gbfans/afterlife-lightkit/(threads)

Thread 1 (2022-06-20):

What is the preferred software for development?

cfunseth, 2022-06-20:
There will likely be library dependencies for the software, and the hardware may require modifications from multiple people. This makes documentation difficult if everyone is using a different environment to develop in.

I'd throw a vote out for just using Arduino and KiCAD since these are both popular and available for anyone to use.

Just throwing it out there for consideration before design progresses too far.

ajquick, 2022-06-20:
I would agree that those are my preferences as well. Once you start using VS Code or other software it becomes more complicated for end users to compile their own code.

The PCB was designed in Kicad, so that's what the source will be provided as. I may put up a PDF schematic here soon as I like to test a physical board before I release anything else publicly.

Thread 3 (2022-06-21):

[FEATURE] Recreation of 1984 Cyclotron Effect

prodestrian, 2022-06-21:
The most basic requirement for this project to get to a first release is the 1984 Cyclotron Effect, effectively a "Hello World" task but a great way for us to refine our processes before jumping into the heavier stuff.

Based on the [schematic](https://github.com/gbfans/afterlife-lightkit/blob/main/HARDWARE/Schematic.pdf), I assume we'll be running `WS2812` LED strips (Neopixels)?

## Acceptance Criteria
- I should be able to compile and upload the Arduino code to the Microcontroller
- The four LEDs should illuminate in a looped sequence (approx 500ms each) as soon as the sketch starts, one at a time

## Out of Scope
These can be added in subsequent updates once the proof of concept is tested and more of the code boilerplate has been implemented:
- Multiple LEDS per Cyclotron light (eg 4x5LEDs, or a 20-LED strip)
- Customization (interval, brightness, direction, number of LEDs)
- Fadeout effects (incandescent-lamp style)

## Proof of concept sketch
(NOTE: Untested as I don't currently have the hardware available, but in theory this should upload and work with minimal changes)
```ino
#include <Adafruit_NeoPixel.h>

// D1 / GPIO5 = Cyclotron Light Data Out
#define CYCLOTRON_PIN 5

// How long to illuminate each Cyclotron LED
#define CYCLOTRON_DELAY 500

// How many LEDS in the Cyclotron
#define CYCLOTRON_LED_LENGTH 4

// Parameter 1 = number of pixels in strip
// Parameter 2 = Arduino pin number (most are valid)
// Parameter 3 = pixel type flags, add together as needed:
//   NEO_KHZ800  800 KHz bitstream (most NeoPixel products w/WS2812 LEDs)
//   NEO_KHZ400  400 KHz (classic 'v1' (not v2) FLORA pixels, WS2811 drivers)
//   NEO_GRB     Pixels are wired for GRB bitstream (most NeoPixel products)
//   NEO_RGB     Pixels are wired for RGB bitstream (v1 FLORA pixels, not v2)
Adafruit_NeoPixel cyclotron = Adafruit_NeoPixel(CYCLOTRON_LED_LENGTH, CYCLOTRON_PIN, NEO_GRB + NEO_KHZ800);

uint16_t currentCyclotron = 0;
unsigned long previousCyclotronMillis=0;

uint32_t red = cyclotron.Color(255,0,0);

void setup() {
  cyclotron.setBrightness(255); // set brightness

  cyclotron.begin();
  cyclotron.show(); // Initialize all pixels to 'off'
}

void loop() {
  tickCyclotron();
}

void tickCyclotron() {
  if (
    ((unsigned long)(millis() - previousCyclotronMillis) >= CYCLOTRON_DELAY)
    || previousCyclotronMillis == 0
    ) {
    previousCyclotronMillis = millis();
    cyclotron.clear();
    cyclotron.setPixelColor(currentCyclotron, red);

    currentCyclotron++;

    if (currentCyclotron == CYCLOTRON_LED_LENGTH) {
      currentCyclotron = 0;
    }

    cyclotron.show();
  }
}
```

ajquick, 2022-06-21:
Yes this works.

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

I also made the following change:

````
// How long to illuminate each Cyclotron LED
#define CYCLOTRON_DELAY 20

// How many LEDS in the Cyclotron
#define CYCLOTRON_LED_LENGTH 40
````

And now it functions as the Afterlife Cyclotron.

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

@cfunseth also has written code that already works for Afterlife and has the ramping speed up effect: https://github.com/cfunseth/AfterlifeCyclotron

If I recall it also has 1984 mode that places the pixels in the correct spot depending on the number of LEDs.

Currently my test ring has 40 leds, but I believe the final version that will ship with the kit has 32 or 35 LEDs.

ajquick, 2022-06-21:
BTW. I really like the idea of having separate branches for things to test maybe? I typically just commit to master, but I think separate branches for each effect being tested or whatever would be good?

The basic bare setup will be easy, it is once we start adding all the different modes and customizations that things will get hard. So if we can find a way to keep those very portable that would be good.

I'm using just an Arduino and LED ring to test as I don't have an ESP8266 on hand at the moment, but it should be easy to swap between the two devices for the time being.

ajquick, 2022-06-21:
I attempted to get the powercell sequence working, however my knowledge of the Neopixel library fell flat. I was unable to turn the LEDs off in reverse sequence.. even though it *should* have done it.

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

```c
#include <Adafruit_NeoPixel.h>

// D1 / GPIO5 = Powercell Light Data Out
#define POWERCELL_PIN 3

// How long to illuminate each Powercell LED
#define POWERCELL_DELAY 20

// How many LEDS in the Powercell
#define POWERCELL_LED_LENGTH 40

// Parameter 1 = number of pixels in strip
// Parameter 2 = Arduino pin number (most are valid)
// Parameter 3 = pixel type flags, add together as needed:
//   NEO_KHZ800  800 KHz bitstream (most NeoPixel products w/WS2812 LEDs)
//   NEO_KHZ400  400 KHz (classic 'v1' (not v2) FLORA pixels, WS2811 drivers)
//   NEO_GRB     Pixels are wiblue for GRB bitstream (most NeoPixel products)
//   NEO_RGB     Pixels are wiblue for RGB bitstream (v1 FLORA pixels, not v2)
Adafruit_NeoPixel powercell = Adafruit_NeoPixel(POWERCELL_LED_LENGTH, POWERCELL_PIN, NEO_GRB + NEO_KHZ800);

uint16_t currentPowercell = 0;
unsigned long previousPowercellMillis=0;

uint32_t blue = powercell.Color(0,0,255);
uint32_t off = powercell.Color(0,0,0);

uint16_t powercell_direction = 1;

void setup() {
  powercell.setBrightness(50); // set brightness

  powercell.begin();
  powercell.show(); // Initialize all pixels to 'off'
}

void loop() {
  tickPowercell();
}

void tickPowercell() {
  if (
    ((unsigned long)(millis() - previousPowercellMillis) >= POWERCELL_DELAY)
    || previousPowercellMillis == 0
    ) {
    previousPowercellMillis = millis();
    //powercell.clear();

    if (powercell_direction > 0) {
      powercell.setPixelColor(currentPowercell, blue);
    } else {
      powercell.setPixelColor(currentPowercell, off);
    }

    currentPowercell = currentPowercell + 1 * powercell_direction;

    if (currentPowercell == POWERCELL_LED_LENGTH) {
      powercell_direction = -1;
    }else if (currentPowercell == 0) {
      powercell.clear();
      powercell_direction = 1;
    }

    powercell.show();
  }
}
```

ajquick, 2022-06-21:
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

```c
void tickPowercell() {
  if (
    ((unsigned long)(millis() - previousPowercellMillis) >= POWERCELL_DELAY)
    || previousPowercellMillis == 0
    ) {
    previousPowercellMillis = millis();
    //powercell.clear();

    for (int i = 0 ; i < POWERCELL_LED_LENGTH; i++) {
      if (i <= currentPowercell) {
        powercell.setPixelColor(i, blue);
      } else {
        powercell.setPixelColor(i, off);
      }
    }

    currentPowercell = currentPowercell + 1 * powercell_direction;

    if (currentPowercell == POWERCELL_LED_LENGTH) {
      powercell_direction = -1;
    }else if (currentPowercell == 0) {
      //powercell.clear();
      powercell_direction = 1;
    }

    powercell.show();
  }
}
```

prodestrian, 2022-06-21:
Excellent! So, to be completely clear the above code I posted was just to verify that it would work on the hardware, which is why it's so hastily written.
So the next step is to refactor this into something cleaner and more permanent as a starting point to build upon, and that can be our first actual release of the code before we move onto the next feature.
I'm happy to include the POWERCELL feature as part of that, I've already got most of that code written cleanly.

I think the next feature is wrapping our heads around the Configuration, I was going to create a new Issue to track this because it may need some discussion and investigation. I see you've already got something to look at in #4 so I'll have a play when I pick up an ESP8266 later this week.

For that feature, we'd want to be able to manipulate the speed (CYCLOTRON_DELAY) using the web browser.
If we get that minimum requirement working, everything after this point should be smooth sailing because it's all just variations of the same thing.

prodestrian, 2022-06-21:
And yes, separate branches are a good idea, we almost never want anything being committed to `main` directly. I usually lock that branch to force every change to go through a PR (and a code review). Should hopefully reduce the chance of bad code or regressions being introduced.

prodestrian, 2022-06-24:
I finally have an ESP8266 as well now, so tomorrow I'll solder the headers on and get it working with my Neopixels.

I've played with WLED quite a bit, it's why I purchased an ESP32 originally. I don't think we really need it here, but some of the animation code could be handy.

I'm not worried about running multiple animations at once, I've already got two separate Neopixel strips animating on my pack while _also_ mixing 3 channels of Audio playback and reading/writing packets over Serial. I can be firing and overheating while changing my volume (from the wand) and playing music at the same time. Zero lag if the code is written efficiently.

Here's a video demo of where my animations are at (I'm building a new pack so these will be rewritten in the near future):
https://www.youtube.com/watch?v=F4Oospy0Dfc
There's a fade-up/down on the PowerCell and Cyclotron during startup.
The Cyclotron LEDs also have a fake "incandescent" fadeout when they switch off.

I'm doing all of this with TimedAction: https://playground.arduino.cc/Code/TimedAction/

What I'd like to do is abstract this all out to smaller components so our main sketch only has to be concerned with the "business logic".

Here's a mockup of what we could end up with:
```ino
// 60-LED Neopixel ring, for example
#define CYCLOTRON_LENGTH 60
// Max brightness
#define CYCLOTRON_BRIGHTNESS 255

Cyclotron cyclotron = Cyclotron(CYCLOTRON_LENGTH, CYCLOTRON_BRIGHTNESS);

void setUp() {
    // Initial Speed
    cyclotron.setSpeed(500);
    // Afterlife Mode
    cyclotron.setMode(MODE_AFTERLIFE);
    // Cyclotron is off by default
    cyclotron.disable();
}

void loop() {
    if (packIsActive()) { // Some magic function which reads the state of the power switch
        cyclotron.enable();
        if (packIsFiring()) { // Fire button is pressed
            // Tells the Cyclotron to spin faster
            cyclotron.setSpeed(250);
        } else {
            // Return cyclotron to regular speed
            cyclotron.setSpeed(500);
        }
    } else {
        // Switch off the Cyclotron LEDs
        cyclotron.disable();
    }

    // This is the line which makes it actually work
    cyclotron.update();
}
```

Obviously the above code is completely artificial, but note how we're not really having to deal with the LED animations or timers here, and there's no blocking code either. The Cyclotron class would initiate the TimedAction instance and the Neopixel strip, we don't have to think about it in the main sketch.

We can tell the Cyclotron and PowerCell instances how long we've been firing for, and have them calculate/adjust their own speed accordingly (or maybe keep it simple and just say `cyclotron.setIsOverheating(true)`). There's a lot of possibilities, we just need to imagine them! :smiley:

Thread 4 (2022-06-21):

Portability between Microprocessors?

ajquick, 2022-06-21:
For this version of the hardware I have decided to use the ESP8266 as the microprocessor. The main reason for that was the following:

* It's cheaper than most Arduino clones (nano, mini, micro),
* It has a 32-bit processor, which may be better at driving a large number of LEDs quickly(?)
* It has a ton of hardware features like Wi-Fi and is more next-gen than most simple Atmega chips.

That being said. There will only be a few things that the ESP8266 can do that the Arduino chips cannot and that is primarily running the web server and Wi-Fi connection. I think it would be ideal to allow for portability between boards so that an Arduino could be used if need be.

It would be good to have the settings stored and accessible with the ability to change them over the command line.

I've actually already written two utilities for a program that are run on the ESP32 to change settings:

https://github.com/CNCxyz/Grbl_Esp32_Utility (Qt program, EXE)
https://github.com/CNCxyz/Grbl_Esp32_Web_Utility (Web utility)

The web utility is what I would focus on and could adapt. It allows someone to plug their device into a computer and visit a web page in Chrome. Chrome can communicate with the device over the serial port and the configuration can be read and written back without downloading anything.

That would help people that may not want to go through the hassle of downloading Arduino and compiling customizations.

I think having the ability to disable Wi-Fi completely using the serial port would be ideal as well. It would help speed up the boot time.

prodestrian, 2022-06-21:
Just leaving this note for later, it should be possible to add conditional includes in our Arduino code which only require/enable certain features based on the board type. So if you're compiling for an ESP8266 it will include the Wifi features, otherwise (eg Arduno Nano) it will just use all the configuration default values.

We'll want a default config file (eg `config.h.default`) which users clone to `config.h` and modify all the settings (Cyclotron speed, mode, directions, etc) as needed. We'll want `config.h` gitignored too. This way users can still `git pull` to get the latest features.

We may need to implement a Configuration provider which is intelligent enough to load settings from the three different scopes:
1. From the Wifi-defined configuration (if enabled)
2. From the user-overridden `config.h`
3. From the hard-coded default value

One thing I'm not sure about is where we'll actually store this configuration (it may need a separate Issue to track this).
I know the ESP8266 has an onboard EEPROM, but it has a limit of `100,000` write cycles. Is that enough?
If we're only writing to EEPROM when Configuration is changed, it should be fine (you could change your CYCLOTRON speed 25 times a day and still get 11 years out of your device). But if we're not smart about it and we're constantly writing to it, we're going to burn out the board.
The alternative is to write to the SD Card. I personally prefer the sound of this, but I don't know if this will introduce undesirable latency, or how difficult it will be to read/write config files to the filesystem. I'd hope that there's some libraries around to handle this already, but I don't know how lightweight they are.

ajquick, 2022-06-21:
I would prefer the EEPROM approach personally. I don't think we'll have a problem with that many cycles. These D1 Mini boards are about $3-4 on Amazon, so not bad.

For the web server portion, I think we will need to implement a LittleFS (file system) to store a HTML page, CSS and could potentially also store the config there as a JSON file. Space will be tight, but I'm sure we wouldn't be using more than a 1/4 of the memory space for that.

Definitely plan on having a ```#define BOARD = ESP8266;``` or something at the top to allow for the includes to be changed.

prodestrian, 2022-06-24:
I've done some testing and added some notes in #5 related to the filesystem and webserver.

[Apparently](https://arduino.stackexchange.com/questions/34496/how-to-have-compiler-know-whether-arduino-or-esp8266) we can use this to detect the device automatically, so users won't need to change anything themselves when compiling:
```ino
#if defined(__AVR__)
// AVR specific code here
#elif defined(ESP8266)
// ESP8266 specific code here
#endif
```

Thread 5 (2022-06-22):

Webserver Demo

ajquick, 2022-06-22:
I have created a branch with a webserver demo:

https://github.com/gbfans/afterlife-lightkit/blob/webserver/SOFTWARE/Webserver.ino

Currently the code will do the following:

- Start the access point with the name "Afterlife " + MAC ADDRESS
- Start a webserver on board the ESP8266
- Start a DNS server (255.255.255.0)
- Set a static IP address (10.10.10.1)
- Start the LittleFS file system (doing nothing currently)
- Initialize the Eeprom (no data stored currently)

Now it is supposed to start the DNS server and handle all requests to the internet and then display a Hello World page for everything. However it does not currently do that.

Accessing through http://www.msftconnecttest.com/redirect or the device's static IP of http://10.10.10.1/ does show the "Hello World" page.

ajquick, 2022-06-24:
Can you push your code to the webserver branch? Getting interactions is the next step, and its something I can focus on doing if you would prefer. I just need API end points to save config data and trigger events.

>But if I try accessing a site I've visited previously, I get a CONNECTION_REFUSED error because 99% of those sites are on HTTPS (usually with HSTS-enabled, which my browser remembers and won't allow me to connect via HTTP). So my browser tries to connect to port 443, but the webserver is only listening on port 80, and so I get the error.

This makes sense. Also because on sites previously visited the DNS is cached on your device, so it's probably trying to connect to whatever IP that isn't the ESP8266.

>Edit: I need to have a play with this: https://github.com/plapointe6/EspHtmlTemplateProcessor
>Maybe starting with this tutorial: https://randomnerdtutorials.com/esp8266-web-server-spiffs-nodemcu/

These both use SPIFFS as the file system. I had planned on going with LittleFS since I think it is a little easier to deal with loading files on to the ESP8266. If you have any insight into that, let me know. Basically I think LittleFS can just have a "data" directory with raw files (index, js, css, jpg.. etc) that can be accessed or fed directly instead of having things in the Arduino code.

prodestrian, 2022-06-25:
Yep, I'll push my code shortly :+1:

> These both use SPIFFS as the file system. I had planned on going with LittleFS since I think it is a little easier to deal with loading files on to the ESP8266. If you have any insight into that, let me know.

After a bit of research, it looks like SPIFFS is deprecated/unsupported anyway, plus LittleFS is apparently more performant. So let's stick with LittleFS:
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
https://arduino-esp8266.readthedocs.io/en/latest/filesystem.html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,times%20faster%20for%20most%20operations.

I can't find any HTML template libraries which support LittleFS, but I don't think that's a dealbreaker anyway (we're not going to building anything too complex here).

I was able to convert the Webserver demo to store the HTML file in LittleFS, the only catch is that I couldn't get it working with `ESP8266WebServer` so I had to swap out for `ESPAsyncWebServer` (which also requires installing `ESPAsyncTCP`).

I'll commit what I have so you can try it out: #9

prodestrian, 2022-06-25:
Now that I've got my hardware connected (See #7) I tried to perform an integration test with the Webserver code and my Neopixel code.
Everything connects and I can even click the HTML buttons to change my animation speed.
But then **the Wifi network drops out**, within about 10 seconds. The LED animations continue fine.

I'm currently powering the Neopixels directly from the ESP8266, I thought maybe the current draw was too much for the Wifi. But even after disconnecting the Neopixels entirely the Wifi still drops out.

So I commented out my animations and left just the webserver (and dependencies), the Wifi stays up fine. Next thing I tried was removing the animations and just setting the colour of one of the Neopixel strips based on the button presses (no timers etc, just the Adafruit Neopixel library). This still dropped out unfortunately. So pretty much ruled out my animations and the Timers, I think it's Neopixels interfering with Wifi.

I jumped onto the Adafruit GitHub and searched for ESP8266 and found this Issue:
https://github.com/adafruit/Adafruit_NeoPixel/issues/176

That led me here: https://forum.arduino.cc/t/interrupting-the-neopixels-help-needed/495593

> One of the problems in that the NeoPixel library temporarily disables all interrupts when issuing data, then re-enables them when done. Since a lot of those functions are essentially always updating the LEDs, well then you don't have room much for anything using interrupts.

**We're not be able to use Wifi and the Adafruit Neopixel library at the same time.**

What alternatives are out there?
https://github.com/Makuna/NeoPixelBus/wiki/Library-Comparisons
NeoPixelBus seems to have been designed for exactly this reason. I brought it into my sketch with minimal effort, but it looks like it unfortunately requires you to use specific GPIO pins on the ESP8266 (it ignores the pin you configure). This won't work if we're already committed to specific pins on the PCBs. Also doesn't seem to like running multiple Neopixel strands at once.

So, next up I tried FastLED. It took a significantly bigger rewrite to get up and running. But it mostly works (with a couple of weird hacks that I found others had to use on the ESP8266), and the logic of my original animations translates very pretty easily. In fact I actually like some aspects of it more than the Neopixel library.

I now have a working demo with the Cyclotron LEDs and Webserver/Wifi. I can control the speed of the Cyclotron over Wifi:
https://www.youtube.com/watch?v=rnBNd0qfW8Q

There are still some random glitches/flickering in the Cyclotron LEDs though. If I disable Wifi it runs smoothly, so there's potentially some adjustments/optimizations to be made there. I've barely scratched the surface of the documentation.
Also I'm not (currently) using a 3.3V logic level shifter, I forgot to pick one up yesterday so it'll be another week before I can get one. It's possible that's causing the flickering, very hard to tell though.

If it's not a solvable problem, then that unfortunately rules out "Party Mode" :rofl:

ajquick, 2022-06-25:
Regarding the flicker, are there any wires or large metal surfaces (ground planes) near the Wi-Fi antenna?

Perhaps a good idea to check to see what Wled has done because I suspect they have tackled all these issues. They already use the Async webserver, LittleFS, FastLED.. etc. So it is definitely possible.

prodestrian, 2022-06-26:
It's plugged into a breadboard sitting on a wooden desk, I don't think there's any interference.

I'm installing WLED to see if I have the same problem, but I'm feeling pretty confident it's a hardware issue now.

I also ordered some [bidirectional logic level converters](https://core-electronics.com.au/logic-level-converter-bidirectional.html), I did find a `74LVC245` in my collection but it seems to be 5V to 3.3V, not 3.3V to 5V which is what I need (unsuitable for Neopixels). So it'll be at least a few days before that arrives.

prodestrian, 2022-06-26:
I've been trying to decipher the code from WLED but it's so heavily abstracted that I just can't understand it. I did find a few small configuration options which seemed to relate to ESP8266 but none had any effect. The flicker remained when I brought it into my sketch.
Eventually I found this post: https://github.com/FastLED/FastLED/issues/849
which linked to this commit: https://github.com/stnkl/FastLEDHub/commit/54bbaf1d12c89977501e1dea95f9347ae0a954ed

I copied it into my sketch and :boom: no more flickering. My guess is that WLED isn't affected because they're doing all the LED communication themselves at the lowest (pin) level (which is why there's no `FastLED.show()` anywhere in their code).

It's an ugly hack but it should be enough to keep us going, I'll include some comments so we can periodically check on the original issue and see if someone resolves it.

prodestrian, 2023-06-12:
The demo of the webserver is completed (as documented in #10) so I believe we can close this too.

Closed 2023-06-12.

Thread 6 (2022-06-22):

ESP8266 Interrupt Pins

ajquick, 2022-06-22:
An important detail to discuss, know about. The ESP8266 has several interrupts which can be used on nearly every GPIO pin with the exception of D0/GPIO16, When I was designing the schematic, I only had 5 pins left to assign my inputs for control over the lights. 1 of them was output only and 1 of them had no interrupt (D0/GPIO16).

I determined to assign the input signals in the following way:

D0 - Fire input signal
D5 - Video game change mode signal
D6 - Activate venting signal
D7 - Activate lights / enable signal

D5 - D7 are able to have interrupts attached, D0 (fire signal) is not able to.

I decided that it was least important to capture the fire signal immediately. The reason for this is that I imagine when someone presses the fire button, they will be holding that button down so it can be captured at the start of the loop as long as it is still held down. Similarly the activate / enable and venting signal are expected to be on for a fairly long time when they are activated, but are more important than the fire signal.

Lastly the video game change signal is expected to always be a very short burst or short tap. This is actually the only one where an interrupt is very important as we don't want to miss the signal. The rest don't **need** the interrupt, but enable and vent do have the ability to have them if they need.

prodestrian, 2022-06-24:
Do we actually _need_ interrupts though? I've never had any issues with responsiveness, my fire button responds to even the shortest/lightest touch.

I'm not using the ESP8266 in my projects so I could be missing something, but I have a Teensy 3.2 in my want and I read the button state, if the fire button is pressed it sends a string over Serial to the Teensy 3.2 in the Pack, which triggers the lights/sounds. All of this occurs in a tiny fraction of a second, and I've never pressed the button and had it not fire.

As long as we're not introducing delays into our `loop()` I wouldn't have expected us to have any issues here?
I haven't tested the WebServer with a button yet so I don't know if this introduces lag, but apparently the ESPAsyncWebServer (alternative library) is a more optimised alternative if we need it:
https://github.com/me-no-dev/ESPAsyncWebServer#why-should-you-care

Personally I use the `Bounce2` library to handle buttons/inputs and debouncing, so far everything has been incredibly reliable:
https://github.com/thomasfredericks/Bounce2

Again, there could be other factors I'm not aware of, but I still feel like we can get by without these. Everything I've read suggests that it's not a good idea to use Interrupts for buttons (or human inputs), it's usually for things like sensor data.

I'll try to get some headers soldered to my board tomorrow so I can connect some pushbuttons and verify this, I can try pressing buttons repeatedly while making a lot of simultaneous webServer requests and see if any of the presses are missed or delayed. Maybe then connect up my Neopixels and make sure that it's all 100% asynchronous and non-blocking.

ajquick, 2022-06-24:
>Do we actually need interrupts though?

The only thing I can say is *I don't know*. But I did put thought into it that if we need interrupts, those are the pins to put them on. Change mode may be the only input that may need one, but if everything is kept really fast than it might be okay to not need it.

[ESPAsyncWebServer](https://github.com/me-no-dev/ESPAsyncWebServer#why-should-you-care) seems like a no-brainer if it is comparable in memory usage. For 99.9999999% no one will be using the webserver for anything beyond initial setup. Perhaps the web server should shut down if no one connects to it within the first 2-3 minutes? And a configuration setting to enable / disable the web server would also be good.

Personally how I would set this up on my own pack is to wire everything up. Use the Wi-Fi to configure all my options and then turn off Wi-Fi permanently. If I need it back on, then I could connect over USB to re-enable it.

That is unless having 'party mode' where you can have cool light shows come on based upon a click on your phone is highly desirable for end users.

prodestrian, 2022-06-25:
If we wanted we could have a secret button press to switch Wifi on/off. Maybe while the pack is in shutdown mode, hold the Vent button for 5 seconds to activate Wifi, hold for 5 seconds again to shut it down? Slowly blink the Orange Hat light to show when it's active?

We can also automatically enable Wifi if the Configuration (in either EEPROM or LittleFS) is empty. So you can do your initial configuration, but then it skips enabling Wifi afterwards unless you manually activate it.

Thread 7 (2022-06-24):

[FEATURE] Recreation of 2021 Afterlife Spinning Cyclotron Effect

prodestrian, 2022-06-24:
Just so we have a place to keep all our discussions/ideas for this feature together once the code for #3 is completed.

The requirement here is that we should be able to replicate the spinning Cyclotron from Ghostbusters Afterlife.

NOTE: I don't recall if any PowerCell animation changes would be needed in Afterlife mode?

## Requirements / Ideas
1. It should look like a spinning lamp (which may mean lighting more than 1 LED at a time)
2. It could spin slower on startup and gradually get faster (like a motor ramping up)
3. The direction should be configurable
4. The speed should be configurable
5. The number of LEDS should be configurable (not everyone will use a 60-LED Neopixel strip)
6. The number of LEDs lit at once should be configurable (the "width" of the light)
7. It could spin faster while firing/overheating
8. It could slow down during shutdown before coming to a stop and switching off
9. The starting position should be configurable (an "Offset", ie "LED 26 is the first LED")
10. It shouldn't interfere with 1984 mode (#3)
11. Each LED could quickly fade out instead of instantly switching off (to emulate a "motion blur" effect)

ajquick, 2022-06-24:
>NOTE: I don't recall if any PowerCell animation changes would be needed in Afterlife mode?

There is one split second where the OGB's packs are showing a special animation in the Powercell while firing. Potentially during overheating. It would certainly be a goal to have, but maybe not a must have for the first release as it was seen so briefly.

prodestrian, 2022-06-25:
> There is one split second where the OGB's packs are showing a special animation in the Powercell while firing. Potentially during overheating. It would certainly be a goal to have, but maybe not a must have for the first release as it was seen so briefly.

Hmm, I can't seem to find that shot...do you know the timecode?

There's a good shot of Phoebe's pack at `01:46:01` (just before Egon appears), the PowerCell appears to pause on the top LED before looping again (it's more "sticky" than the 1984 animation). Seems to match the first shot at `00:48:16` during the proton pack test scene. So we can replicate that easily enough.
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

But as far as the OGB packs, I can see a shot at `01:44:54` where what looks like a stunt pack has a special animation on the PowerCell. I notice the Cyclotron lights are all lit up (which isn't possible with the spinning mechanism), and I don't recognise this from any of the other light kits, so it's probably an Arduino based chaser light. We could include this too somewhere (maybe it's a post-firing after-overheating animation, ie while cooling down?)
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

prodestrian, 2022-06-25:
I've now got most of my prototyping testbench together, I cut out a cyclotron and power cell from foam core (it's easier than having a full pack on my bench).

Just to see if everything is working I threw together a simple Afterlife animation, currently running it off an Arduino Uno.
It starts slow and gradually speeds up.

I found that adding a diffuser (a sheet of thick paper here) made all the difference in "motion blurring" the LEDs (which sit about 1.5cm away from the lenses).

Video demo: https://www.youtube.com/watch?v=bHUmGDYBWVs

## NOTES
* I'm still using a 1984-style Power Cell animation for the moment.
* I'm lighting 3 Cyclotron LEDs at once because 1 or 2 at a time wasn't bright enough. This is effectively the "width" of the animation.
* These are two separate Neopixel strips running at once (separate pins)

Update: I just uploaded this to my ESP8266 and it's still working great.

ajquick, 2022-06-25:
>But as far as the OGB packs, I can see a shot at 01:44:54 where what looks like a stunt pack has a special animation on the PowerCell. I notice the Cyclotron lights are all lit up (which isn't possible with the spinning mechanism), and I don't recognise this from any of the other light kits, so it's probably an Arduino based chaser light. We could include this too somewhere (maybe it's a post-firing after-overheating animation, ie while cooling down?)

That's the one and yes I believe the same thing that it was an overheating type feature. I believe Ben Eadie was asked why it happened and he described it as a mix up with the code being on that pack when it wasn't supposed to be.

prodestrian, 2023-06-12:
I believe we have completed this. Yes, there are some requirements I listed further up but they should be covered by other features (such as being able to change direction, which affects more than just Afterlife mode). For now I don't think it's worth worrying about fading out the LEDs or anything like that, what we currently have looks like motion blur anyway. There's some super niche ideas about the power cell but I think we can come back to those later by adding some additional animations for the accuracy obsessed.

So I'll close this as done for now, we can open new issues later to cover those other ideas if we feel the need.

Closed 2023-06-12.

Thread 8 (2022-06-24):

Hardware revision, size constraints, connectors?

ajquick, 2022-06-24:
Looking at the components, I realize there is a possibility to actually shrink down the board to a very small size by stacking the boards on top of one another. The current size is around 70.5mm x 54.5mm, or 3842 mm<sup>2</sup>. I believe it is possible to shrink the board down to around 60mm x 30mm or 1800 mm<sup>2</sup> a saving of 65%. Further shrinkage could occur if the board were to have onboard power regulation and the ESP8266 installed directly to the PCB, but I'm not at that stage yet.

Is there any reason to attempt a smaller design? It would not yield any significant price savings.

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

### Connectors

While selecting components I decided to use a JST PH connector on the board to connect with the RGB light boards. The reason for this was because the standard cable that is used with the RGB light strips, a JST SM connector, does not come in a PCB mount version! (WHY!?)

So I had gone with the JST PH connector as it seemingly fits the bill and is already in use on the other GBFans light kits.

This has left me negotiating with RGB ring light suppliers and having them custom make the boards with the JST PH connector instead of the SM connector so that they can plug directly into the board.

**But.**

This means that any time additional rings or different sizes or different packages were to be used, they would need to have a PH connector added to the wires so that they can interface to the board.

What if instead of having the JST PH connectors on the board, a short JST SM pigtail harness was soldered to the board directly?

This would save from having to custom make custom rings and instead nearly any off the shelf RGB light using the same connector could be used.

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

If this change is done with the SM pigtail, it would also make sense to go through with other changes to make the PCB smaller. The approximately 50 boards I have on order with the V1 design could have the pigtails wired into place without issue as well.

ajquick, 2022-06-24:
Another (albeit temporary) solution would be to use an adapter cable for the first 50 boards.

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

Similar to this from Sparkfun, though in 3 pin configuration: https://www.sparkfun.com/products/retired/14708

ajquick, 2022-06-25:
Current design puts the board at 35mm x 50mm (1750mm<sup>2</sup>), with the Wi-Fi antenna extended over the edge of the board for a total length of ~57mm.

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

The IDC connector and potentiometer has been moved to the back of the board. I am not 100% sure if we will need the potentiometer if speeds and brightness will be configurable via app. If the potentiometer does anything, I think brightness as a default would be good with the ability to override via Wi-Fi.

It is designed to use the JST SM connectors with strain relief.

Some form of 3D printed case or standoffs can be supplied.

prodestrian, 2022-06-26:
Might be a silly question, but will this board also have wand lights or is it strictly pack lights? I've never used any of the GBFans electronics kits so I'm not sure if we're planning to be compatible with the wand kit? Is that what the IDC connector is for?

I guess the wand kit just sends trigger values for:
* Is Enabled (Active)
* Is Firing
* Is Venting
* Is Mode Changing

Which is fine, but it does mean my idea of using the Orange Hat light to indicate Wifi status won't be feasible (we can use the pack lights, it just means you won't be able to see it if you're already wearing the pack).

It also means the Wand won't communicate "Is Overheating", so we'll need to know the overheat duration that long the wand kit is configured for and make sure our code _exactly_ matches (is it `12 seconds` as per the PDF?). Looks like the wand cools down instantly as soon as you stop firing though, so that's easy.

Just want to make sure I lock all this down before I start getting deep into the code.

ajquick, 2022-06-26:
I will need to double check exactly how the signals are passed through from the wand to the sound kit to the light kit. It may be possible to for example, hold down the fire button and flip the enable switch to activate Wi-Fi but I need to double check that.

You are correct in your understanding for the trigger states, but there is zero ability to send signals back from the light kit. An exception to this may be to use the USB port or serial or some other protocol to communicate, but we don't want to rely upon it..

Here is V2 of the light kit. Still kind of tinkering with it. I added the ability to solder wires directly to the PCB for people who want direct access to the pins on the ESP8266, should there be any reason for that. Serial, analog and reset are not broken out.

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

Since the original intention for this whole project was *just* to do the cyclotron, I originally called this the Afterlife light kit. Because it will be able to do everything for the pack lights including the powercell, I am just calling it the Pack Light Controller now. Thoughts?

Wireless Pack Light Controller or GBFans.com Pack Light Controller or Open Source Pack Light Controller?

prodestrian, 2022-06-26:
> You are correct in your understanding for the trigger states, but there is zero ability to send signals back from the light kit. An exception to this may be to use the USB port or serial or some other protocol to communicate, but we don't want to rely upon it..

I use Serial for my pack, I have two Teensy boards communicating over 2 wires (Tx, Rx). Works great for me, I've never had an issue (latency, dropped packets, etc). But it does add a pretty big layer of complexity to the code, so it's not worth doing unless we plan to get a lot more out of it.

Funnily enough I was just wondering about getting access to the pins. If I had the ability to reassign the LED pins in the code (`D1` and `D2` specifically), it would allow me to use them for `I2C`. Which opens up the possibility of all kinds of fun optional addons.

For example:
**Voltage Sensor**
https://www.adafruit.com/product/904
I've got one of these installed, connected, and calibrated in my pack but I ran out of time to actually do anything fun with it.
The plan was to be able to show my Battery state on the PowerCell LEDs (and/or wand bargraph). If I know the output voltage when the battery is full vs almost empty, I can read this and calculate a battery percentage, and figure out when it's time to recharge my pack.

**LED Matrix Driver**
https://www.adafruit.com/product/1427
I currently use this on my bargraph, but it's also great for running 7-Segment LED displays (I'm using them for an in-progress build of the Delorean Time Circuits Display). Combined with the Cyclotron Neopixels and a modified version of the Afterlife animation, you could definitely use this board as the foundation for an Answer The Call Proton Pack.

> Because it will be able to do everything for the pack lights including the powercell, I am just calling it the Pack Light Controller now. Thoughts? Wireless Pack Light Controller or GBFans.com Pack Light Controller or Open Source Pack Light Controller?

:sweat_smile: Tough decision!
I think the GBFans name is definitely worth retaining (prominently) so it relates back to your existing products/ecosystem. GBFans.com OpenPack Light Kit?

ajquick, 2022-06-26:
> I use Serial for my pack, I have two Teensy boards communicating over 2 wires (Tx, Rx). Works great for me, I've never had an issue (latency, dropped packets, etc). But it does add a pretty big layer of complexity to the code, so it's not worth doing unless we plan to get a lot more out of it.

I'll break out the TX / RX pins too just in case, but they will be less easily accessible. In the future I imagine expanding this with SD card for sound files and a wand kit. That setup could use serial for communication. Maybe use an ESP32 as a USB host in the pack and plug the wand board in with a Type C cable.

> Funnily enough I was just wondering about getting access to the pins. If I had the ability to reassign the LED pins in the code (`D1` and `D2` specifically), it would allow me to use them for `I2C`. Which opens up the possibility of all kinds of fun optional addons.

I'm not sold on the current pin assignments. I've learned from reading documentation on FastLED and Wled that there are 2 hardware accelerated pins that are perfect for driving these light strips. I think I'm only using one. The other pins will work of course but in bit banging mode. Just a bit slower. I'm not sure if that will affect us at all because we're looking at ~50-60 LEDs max here. People using Wled and others are looking to drive 1,000+ LEDs at 15-30 FPS.

>GBFans.com OpenPack Light Kit

I like it. No one has used OpenPack before? Perhaps we can have a partnership with the Q-Pack to make one large project.

ajquick, 2022-06-26:
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

ajquick, 2022-06-28:
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

The prototype boards are in! While I don't have the code to replicate any specific effects, I was able to test functionality and control 3 independent LED light rings at the same time.

This board is expected to be sold with a cyclotron ring only. Customers will be able to add additional lights, or update the firmware to unlock additional features at a later date (once this code is done!). For the purposes of this project the "Afterlife Light Kit" will only be expected to replicate the Afterlife Cyclotron effect.

ajquick, 2022-06-29:
Currently having issues with the enable signal from the GBFans Sound Board. For whatever reason the signal is not able to control the on and off request. I may need to add some form of external pull down resistor as the ESP8266 does not have internal pull downs.

ajquick, 2022-07-01:
I ran into some issues with receiving signals from the GBFans Sound Board. As the Sound Board uses 5V for communication and the ESP8266 uses 3.3V, there must be level conversion. The Powercell board has a 100k pull up resistor and the beta (previous) version of the Afterlife light kit has a bidirectional logic level shifter with it's own pull up resistor. The Sound Board appears to have a 10K resistor which limits sourcing current to just 0.5mA.

When all is said and done the bidirectional logic level shifter overrides the Sound Board's signal. This means that as currently designed the board will not work. Since these signals aren't high speed, I believe using a MOSFET or other unidirectional logic level shifter would be best.

I have designed a simple fix that I hope will work for the "Afterlife Light Kit" version of hardware which will have a very limited run. After the hardware tests are confirmed as working, I will make the changes to the "OpenPack Light Controller" before building a prototype of that design.

Testing with these logic converters:
- 74LVC1G07 (single)
- 74VHCT126 (quad)

ajquick, 2022-07-12:
Powercell boards have arrived.

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

prodestrian, 2022-07-23:
@ajquick This all looks super cool! And thanks for the boards, it should really help me to be more confident that the code I push actually works with the hardware. Haven't been able to do much these last few weekends but I have some capacity soon to get back into this and hopefully start closing off some tasks.

"OpenPack" looks perfect too :ok_hand:

ajquick, 2022-07-23:
No problem Chris! I'm currently away for a week myself. Hopefully we can get something going toward the end of the month / August. I think I can start shipping kits to customers in August.

ajquick, 2022-07-28:
Because of the pancake design, I figured it would be best to include a 3D printed case with the kit. That way people can throw it in with double sided tape or Velcro and not run the risk of things shorting out. It also helps with the wire management. The wires will have labels indicating Powercell, Cyclotron and Vent as well for ease of use.

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

(Shown in PLA, the case will be black PETG).

prodestrian, 2022-08-11:
@ajquick boards just arrived, thanks so much! I'm done with events for now (not suiting up again until October) so I should be able to get stuck back into prototyping this weekend. Really looking forward to it, especially once we get some of these tedious tickets closed off (FX Library and Config Manager especially).

I think the connectors you went with were absolutely the right choice, they look solid :+1:

ajquick, 2022-08-12:
That would be great! I'll try to get a bit more of my code uploaded soon. I started working on the config system and the mode / state switching... but have not yet compiled or tested it.

prodestrian, 2022-08-18:
Just a quick update... I only had a few hours free on the weekend, but I did manage to get the boards up and running. Unfortunately it took me an hour to find a USB cable which was thin enough to fit, the placement of the USB port means it interferes with the LED connector wires. I can't tell if this is something you've adjusted in the latest revision though.

Once I found the cable I connected it and it started running your demo sketch (power cell and Cyclotron looping), no issues there. Lights are a bit dimmer than I expected but I don't know if your demo sketch just has the brightness turned way down, we'll see when I upload new code.

I did notice that the vent LED ring unfortunately won't fit inside a 3D printed Q-pack MK3 N-Filter, I can get exact measurements but the walls are too thick. Won't be an issue for anyone using aluminium parts I assume. If it was close I'd just suggest sanding the edges of the LED ring but it's off by a fair bit. This might be something we need to either document or offer alternatives for.

Anyway, at this stage my upcoming weekend is clear so I can finally upload my existing sketch and see if it works, if it does then I'll continue working on that.

I'm also going to pick up a 16 pin connector tomorrow so I can try to interface with an Arduino, to effectively emulate the gbfans soundboard and send the same signals for each state (as documented elsewhere here). I'll wire in the wand switches/buttons so I can replicate all the same features.

@ajquick If you're able to push your configuration code I can try integrating that and testing/building on it, but it's not critical for the FX code at this stage.

Can't wait for the weekend!

prodestrian, 2022-08-20:
## Hardware Testing Update - 20th August 2022
It took a few attempts but I was able to upload the latest sketch to the device (I think I was having some USB issues, was fine after I rebooted my laptop). I modified it to ignore the buttons for now and begin in START mode.
The Cyclotron and Powercell pixels are running as expected, so the hardware is definitely all working.
Also I bumped the brightness up to `255` just so I could compare to the LEDS I was using previously. I'm happy with the brightness, the Powercell looks amazing. Cyclotron looks dimmer because we're currently only illuminating a single pixel at a time, when I connect it to the Powercell connector it looks fine. So that's something we'll take care of with the FX updates.

I also connected the Vent LED ring and added it to the code, it's animating successfully.

I'm now assembling a 10-pin IDC cable so I can prototype further but I think you've already confirmed this part of the hardware is working in #15 . So I'll use an Arduino Nano with 3 pushbuttons (Fire, Vent, Change) and 1 switch (Enable) connected and get it sending the same signals that the GBFans sound board sends.

Thread 10 (2022-06-26):

Configuration and default patterns

ajquick, 2022-06-26:
My thoughts for configuration is as follows.

A JSON file is created that contains a standard set of configuration options. This file can be stored in the file system and will be able to be uploaded through the web app. This JSON file can be manually edited, but it can also be updated via GUI in the web app if need be. When config settings are changed, the JSON file is updated and a restart of processes (but not webserver) is initiated.

Alternatively, we could also be exporting the JSON settings to Eeprom for (potentially) easier access to the variables. Perhaps once the config is updated or a new JSON file is uploaded it would save those settings to Eeprom and not touch the JSON file. Ultimately that may come down to what is fastest and what makes the most sense. Perhaps the pin settings for example cannot be used from JSON, but could be used from Eeprom?

I have created an example of a JSON that I think could possibly work here: https://github.com/gbfans/afterlife-lightkit/blob/configuration-testing/SOFTWARE/data/config.json-example

```json
{
  "setup": {
    "powercell": {
      "pin": "GPIO0",
      "num_of_leds": 15,
      "brightness": 255,
      "speed": 10
    },
    "cycltron": {
      "pin": "GPIO5",
      "num_of_leds": 40,
      "brightness": 255,
      "speed": 50
    },
    "vent": {
      "pin": "GPIO4",
      "num_of_leds": 10,
      "brightness": 255,
      "speed": 10
    }
  },
  "state": {
    "startup": {
      "powercell_pattern": "standard",
      "duration": 5,
      "vent": "off"
    },
    "idle": {
      "cyclotron_speed": "random",
      "vent": "off"
    },
    "firing": {
      "duration": 15,
      "automatic_venting": true,
      "venting_time": 5,
      "vent": "off"
    },
    "venting": {
      "powercell_pattern": "static",
      "cyclotron_pattern": "fadeout",
      "duration": 5
    },
    "restart": {
      "repeat_startup": false,
      "duration": 0,
      "vent": "off"
    },
    "shutdown": {
      "powercell_pattern": "countdown",
      "cyclotron": "slowdown",
      "duration": 5,
      "vent": "off"
    }
  },
  "modes": {
    "standard": {
      "powercell_color": "blue",
      "powercell_pattern": "scroll",
      "cyclotron_color": "red",
      "cyclotron_pattern": "smooth",
      "vent_color": "white",
      "vent_pattern": "strobe"
    },
    "slime": {
      "powercell_color": "green",
      "powercell_pattern": "level",
      "cyclotron_color": "green",
      "cyclotron_pattern": "fluid",
      "vent_color": "green",
      "vent_pattern": "spin"
    },
    "meson": {
      "powercell_color": "yellow",
      "powercell_pattern": "level",
      "cyclotron_color": "yellow",
      "cyclotron_pattern": "fade",
      "vent_color": "red",
      "vent_pattern": "glow"
    },
    "stasis": {
      "powercell_color": "blue",
      "powercell_pattern": "level",
      "cyclotron_color": "blue",
      "cyclotron_pattern": "electric",
      "vent_color": "white",
      "vent_pattern": "glow"
    },
    "party":{
      "powercell_color": "rainbow",
      "powercell_pattern": "strobe",
      "cyclotron_color": "rainbow",
      "pattern": "smooth",
      "vent_color": "rainbow",
      "vent_pattern": "spin"
    }
  }
}
```

Lots of stuff in there is of course not linked to anything in code. So I figured I would outline what I envision the pattern names are and what they would do. Feel free to chime in and provide feedback on any of these.

Cyclotron Specific Patterns

- Snap (1984)
- Smooth  (1984 + fade between)
- Dot (Afterlife)
- Fluid (half fill up the bottom of the cyclotron and show 'splashes' in the top cyclotron holes)
- Electric (some form of pattern that gives an electric feel)
- Spinup (during start up, the cyclotron spins up to speed)
- Slowdown (during shut down, the cyclotron spins down to zero)

Powercell Specific Patterns

- Standard (1984 / Afterlife)
- Scroll (light up like Standard, but then turn off from bottom up)
- Kitt (a dot back and forth)
- Level (the meter fills up and goes up and down, but never reaching zero)
- Countdown (during shut down, the power cell slowly ticks down)

Generic Patterns

- Strobe (all lights flashing)
- Random Strobe (single lights flashing)
- Glow (pulsing slow fade in and out)

There can also be patterns for multi-color things like rainbow.

Those are just things off the top of my head. Obviously only a few of those are an initial **must have**.

prodestrian, 2022-07-01:
Finally finished work for the week so I can get back into all this.
Awesome work on the test script, I was planning to use ArduinoJSON as well, it looks great. I'll see if I can pick up where you left off.

prodestrian, 2022-07-02:
I've been struggling with the code all day (and part of yesterday), got it this far: #11

It's a start, but there's quite a few roadblocks. I'm hitting up against my C coding knowledge, I know how I want to structure things but I struggle to know _how_ to write it in C. The `ConfigManager` is a perfect example, it's only loading a handful of settings but it's already taking a lot of manual effort to do it.

prodestrian, 2023-04-30:
## Progress Update

After some additional proof of concept work, I have scoped out a potential way to organise the Configuration.

**Preset**
This is the highest level of configuration, which determines which combination of settings should be used.
Examples could include:
* 1984
* 1984-Venkman
* 1989
* Afterlife-Stantz
* Afterlife-Phoebe
(So we can differentiate between different packs, such as Venkman/Phoebe's cyclotron lights running counter-clockwise, or Stantz's weird Powercell animation when he was knocked over in Afterlife).

Additionally users will be able to create their own Presets and import/export/share them.
We can also **lock** our presets, users will then need to clone them to make changes.

A preset should be contained within a single JSON file. We can include multiple JSON files on the filesystem (instead of trying to squash everything into one `config.json` file).

**Lights**
Also known as the Light Strips, these are the actual hardware connected to the board.
There are only 3 (currently):
* Cyclotron
* Power Cell
* N-Filter

Configuration involves mapping settings to each of the 3 Light Strips inside each Mode.
We could also call these "Elements" if that makes the configuration easier to follow.

**Mode**
These are different options within each preset, for example the Video Game (TVG) modes.
As [documented here](https://github.com/gbfans/afterlife-lightkit/blob/main/SOFTWARE/AfterlifeLightKit/src/GBFansControl/README.md), the GBFans Soundboard returns a specific Mode when this is triggered via the wand. So we are told specifically "RED", "GREEN", "BLUE", or "ORANGE".

NOTE: The Wand cycles through 8 different modes:
```
Proton Stream, Boson Dart, Slime Blower, Slime Tether, Stasis Stream, Shock Blast, Overload Pulse and Meson Collider
```
However the Soundboard doesn't send this to the lightkit, only the color. So both Slime Tether and Slime Blower are "GREEN".

We can re-map the colors to our own naming convention, for example:
| Mode   	| Name   	|
|--------	|--------	|
| RED    	| Proton 	|
| GREEN  	| Slime  	|
| BLUE   	| Stasis 	|
| ORANGE 	| Meson  	|

And then allow choosing/assigning the Color as part of the Preset. So if a user wanted their Stasis Mode Purple instead of Blue, they could configure this easily. The Color is assigned individually to each lightstrip/Element.

**Potential JSON Schema**

**NOTE: This requires a little more planning.**

JSON Files could/should be given the name of their Preset, eg `afterlife-phoebe.json`.
We will need to limit the length of preset names as per LittleFS requirements:
> The LittleFS implementation for the ESP8266 supports filenames of up to 31 characters + terminating zero (i.e. char filename[32]), and as many subdirectories as space permits.

We can differentiate between default/locked presets and user custom ones by adding a `gbfans-` prefix to the filename.
`gbfans-afterlife-phoebe.json` is still only 28 characters total.

If possible, a checksum should be included in the JSON file (similar to PHP Composer Lockfiles) so that we can easily check for corrupt data before allowing imports, but this will add more complexity to the UI.

**Initialization**
On a blank device there will be no initial configuration files. Although it would be easy enough to upload them as each device is being flashed (before dispatch to customers), ideally this should be an automated process.
Similar to [the solution for the webserver files](https://github.com/gbfans/afterlife-lightkit/issues/17#issuecomment-1528968309), we could automatically compile the preset JSON files into C headers and write them to the filesystem if LittleFS is empty. Or, we can check for a `.initialized` file on the filesystem, if not found then we write the JSON files out (along with a blank `.initialized` file). I wouldn't anticipate this additional check would add any significant delay to startup time, it's already quite fast reading from our demo `config.json` file.

prodestrian, 2023-04-30:
## Additional Configuration Notes

Further to the above, we will still require a separate `config.json`. At a minimum this will define the default Preset, and potentially any global customizations (such as the Order in which each TVG mode should be looped through, so potentially when "Slime Mode" is received from the Wand, it could instead switch to "Stasis Mode").
Depending on whether hardware can be instantiated dynamically, we could also use this to store hardware configuration (such as LED strip length if someone has more/less for their Cyclotron, or wants to use a single powerful LED for their N-Filter). We could also use this to store settings for individual spare pins, perhaps if someone wants to solder their Afterlife Gearbox switch to a spare pin and use it to toggle Modes between Classic/Afterlife.

We should be able to abstract the hardware out further too, so that our Lights class simply has 3 LED strips defined of varying lengths, each one is converted to an FX class. As we set States in the Lights class, we use Configuration to tell each FX instance what to do (animation, speed, etc). This should allow us to remove a significant amount of code.

We could (in theory) abstract our Light class even further, so that we don't require individual functions for each State.

prodestrian, 2023-06-11:
## Configuration Server Progress Update

I attempted to use [WifiManager](https://github.com/tzapu/WiFiManager/) in this project however it causes weird flickering of the LEDs (the first LED in each strip flashes randomly). I have attempted to work around this but it might be an issue at the hardware level.
So I switched to ESPAsyncWebServer, but this seems to have the same problem.

This suggests it's an issue with either our Lights or Control classes (either writing the LED data, or reading from the GPIO pins). After some trial and error it seems to be our `lights.update();` call, if I comment this out the flickering disappears (even though the LED strips have been initialized).

So, I completely disabled the Cyclotron/NFilter LED strips and FX instances but the same issue still occurs (in case it was due to having multiple timers running). I then disabled the check from the ramp instance, still no luck. I removed the updateBrightness call so the FastLED write (`FastLED[0].showLeds(255)`) would be as simple as possible. Again, same flickering. I removed the FastLED writes entirely so it would just be checking for updates without writing them. This seems OK.

It must be a FastLED + Wifi conflict, which gives me something to look for:
https://forum.makerforums.info/t/i-could-not-get-the-flicker-to-stop-on-a-esp8266-with-arduinoota-wifi/64610
https://github.com/FastLED/FastLED/issues/306

Interestingly it looks like FastLED 3.6.0 was released 2 weeks ago, I was still running 3.5.0. It says there have been improvements, so I will upgrade:
https://github.com/FastLED/FastLED/blob/master/release_notes.md
It still flickers.

Someone in one of the threads suggested removing the `#define FASTLED_ALLOW_INTERRUPTS 0` which I added previously. This reduced the flickering but it's still there.

I then found `#define FASTLED_INTERRUPT_RETRY_COUNT 0`, adding this to `Lights.h` seems to have fixed the flickering.

I added the following web server endpoint:
```c++
    // Send a GET request to <IP>/get?message=<message>
    server.on("/get", HTTP_GET, [] (AsyncWebServerRequest *request) {
        String message;
        if (request->hasParam(PARAM_MESSAGE)) {
            message = request->getParam(PARAM_MESSAGE)->value();
            if (message == "idle")
            {
                lights.setState(IDLE);
            } else if (message == "wifioff") {
                // Turn off Wifi
                WiFi.mode(WIFI_OFF);
            } else {
                lights.setState(INACTIVE);
            }
        } else {
            message = "No message sent";
        }
        request->send(200, "text/plain", "Hello, GET: " + message);
    });
```

When connecting to the device over Wifi this URL lets us change the pack state from IDLE to INACTIVE and back again. This is working well, the lights are updating without flicker, however there is a moderate amount of lag (more noticeable on the Powercell).

So I included a `?message=wifioff` feature which should turn off the Wifi. If I leave the lights in IDLE (spinning) mode and hit this URL, I would expect it to just kill the Wifi connection but it also stops the lights, potentially because the server is still running.
So I changed this to `server.end()`, the lag remained.
I tried:
```c++
server.end();
WiFi.softAPdisconnect(true);
WiFi.mode(WIFI_OFF);
```
It lags at first, but after a few seconds it seems to improve.

So the next test is to have the Wifi switched off at startup and go immediately into an idle animation.
Then, send a string over Serial to switch the Wifi on and start the webserver.
Then use the webserver to toggle the idle animation on/off.
Finally use the webserver to stop the Wifi connection.
All of this should occur without introducing lag or restarts.

This seems to be working, I can turn Wifi on/off, and I can still access the webserver even if it is initialized late:
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

I experienced unusual behaviour, I switched the animation state over the webserver and it seemed to cause the device to restart. I have added a serial output to detect this and I don't believe this is actually occurring (more than likely it's my Chrome browser doing pre-fetching, so it hits the URL even though I haven't actually clicked "enter").

Starting Wifi causes the LED animations to pause briefly. If Wifi fails to connect it can be a 10 second pause.

I don't believe either of the above are problems.

However turning off Wifi after several attempts did seem to cause a fatal exception:
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
This may be due to the serial strings I am using for debugging, so I will move onto the Wifi Activation feature now in case it's a false alarm.

prodestrian, 2023-06-11:
## Enabling On-Demand Configuration Mode

We are not able to use hardware (ie a separate switch) to enable WiFi/Configuration, and we don't want it enabled on startup unless requested as this introduces severe performance issues.

So we need a way to enable WiFi and the Configuration webserver on-demand using only signals from the Soundboard (and the Wand).

I believe a specific sequence of signals within a set interval would work.

The first requirement is having the ability to keep track of the last X signals received. I have now implemented this, it knows the last 5 signals/commands.
If I switch the pack on/off 3 times I see the following result:
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
(Startup => Powerdown => Startup => Powerdown => Off)
5 signals isn't enough of a history so I will increase this to 7:
```
Changed! - Old: 14, New: 0
History:
	0: 0
	1: 14
	2: 1
	3: 14
	4: 1
	5: 14
	6: 1
```

Next we need a way to concatenate these into a string we can compare against (My C++ knowledge is lacking here, there's probably some more efficient way to do this comparison but I don't have time for that kind of deep dive right now).
Here is what I came up with:
```
Changed! - Old: 1, New: 14
History:
	0: 14
	1: 1
	2: 14
	3: 1
	4: 14
	5: 1
	6: 14
Changed! - Old: 14, New: 0
History:
	0: 0
	1: 14
	2: 1
	3: 14
	4: 1
	5: 14
	6: 1
Sequence Matched!
Sequence Matched!
Sequence Matched!
Sequence Matched!
```
So in this case I was able to compare against a hard-coded sequence, and once received it can trigger additional code.

I have added debouncing so the sequence match is only returned once.

This means if I switch the pack on/off 3 times and wait for the shutdown to finish, it starts Wifi:
```
	 Connected!
Changed! - Old: 0, New: 1
Changed! - Old: 1, New: 14
Changed! - Old: 14, New: 1
Changed! - Old: 1, New: 14
Changed! - Old: 14, New: 1
Changed! - Old: 1, New: 14
Changed! - Old: 14, New: 0
Starting Web Server
IP Address: 192.168.1.19
```

So the next step is to have this action both start and stop the webserver, to rule out the fatal exception I was receiving earlier as being caused by Wifi deactivation.

This seems to be working, no exceptions that I can see:
```
Changed! - Old: 0, New: 1
Changed! - Old: 1, New: 14
Changed! - Old: 14, New: 1
Changed! - Old: 1, New: 14
Changed! - Old: 14, New: 1
Changed! - Old: 1, New: 14
Changed! - Old: 14, New: 1
Changed! - Old: 1, New: 14
Changed! - Old: 14, New: 0
Starting Web Server
IP Address: 192.168.1.19
Changed! - Old: 0, New: 1
Changed! - Old: 1, New: 14
Changed! - Old: 14, New: 1
Changed! - Old: 1, New: 14
Changed! - Old: 14, New: 1
Changed! - Old: 1, New: 14
Changed! - Old: 14, New: 1
Changed! - Old: 1, New: 14
Changed! - Old: 14, New: 0
Stopping Web Server
```

After starting/stopping the webserver and then booting the pack, it seems to be working smoothly (idle, firing, overheat, shutdown, etc). There's a tiny amount of lag on the powercell at times but I don't think it's a major issue right now.

prodestrian, 2023-06-11:
## Wifi Access Point

The above demo currently connects to my home WiFi (which occasionally fails to connect). We would prefer to have this as an access point instead.

So I will bring in some of the demo code we already have from #5 and get the webserver working as a Wifi hotspot.
This seems to work:
```c++
#ifndef APSSID
#define APSSID "GBF-LK-" + WiFi.macAddress()
#define APPSK  "ghostbusters"
#endif
```
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

However:
1. I can't see the SSID on my phone
2. I can't connect from my laptop (the password is rejected)

I'm certain we had this working previously.

So I uploaded the previous webserver demo code to see how this behaves, and it still refuses to connect from either device.
So I tried the default ESP8266 `WifiAccessPoint` demo and had the same problem. Eventually via the Arduino IDE I ran a full filesystem flash (which includes Wifi configuration) and this seems to have fixed it, so I can connect from my laptop (still unable to connect via phone). It's possible my Wifi Configuration was corrupted from my WifiManager attempt earlier.

I uploaded our sketch and can see the SSID:
```
Starting Web Server
WiFi SSID: GBF-LK-48:55:19:14:DB:5D
```
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

However I still couldn't connect from either device.

It looks like the DNSServer needs to be always running, regardless of whether WiFi is active.

I was able to trigger the WiFi and connect from my laptop, and access the demo page.

I disconnected the WiFi and tried to power up the pack. The signals were received but the lights did nothing. I restarted and still can't get the lights to switch on when I power up.
My lights are completely not working right now, I can't see anything in the code which would cause this.
I've tried demo Neopixel and FastLED sketches and they're not working either.

The default blink sketch works fine, the ESP8266 seems to work. I disconnected the Arduino Nano (which I'm emulating the soundboard from).

So there might be a hardware problem with the GBFans board. I will break out my multimeter and try to debug.

ajquick, 2023-06-11:
Just a reminder with the hardware, make sure the output enable is active on
the level shifter. The lights won't work without it and may be why it's not
working with the generic demo code.

-AJ Quick

prodestrian, 2023-06-11:
You're absolutely right, I thought I still had that in the demo code but I had reverted it for another project.

My `Serial.begin()` was sitting at the end of the `setup()` function, so it was starting Serial _after_ loading configuration, which is why I didn't see the `Opening config file failed.` error (which would have saved me a lot of debugging).
This was a good opportunity to overhaul/simplify the debug process, so I've defined two new methods:
`debug(x)`
`debugln(x)`
And a new constant for debug mode:
`#define debug 0`
(Set to `1` while debugging).
This replaces all `Serial.print()` and `Serial.println()` calls.

With debug mode disabled, the LED animations are completely smooth now. There's some minor lag when WiFi has been activated, but as soon as WiFi is switched off again it runs fast. So if the lag only appears while the user is using WiFi then I don't think there's any big issues here.

I'm going to leave it running for an hour or so and see if there are any exceptions/crashes or memory leaks.

Then I can pick back up on the web UI portion of this task (which I started last night, so far it's going well).

prodestrian, 2023-06-12:
## Light Preset & JSON Configuration Progress Update

After hours of issues with memory leaks and JSON parsing problems, I finally have working code to read values from JSON files and convert them into usable properties.

Example JSON config file:
```json
{
    "modes": {
        "proton": {
            "color": {
                "powercell": "0x0000FF",
                "cyclotron": "0xFF0000",
                "nfilter": "0xFFFFFF"
            },
            "states": {
                "idle": {
                    "powercell": {
                        "effect": "SPINNING"
                    },
                    "cyclotron": {
                        "effect": "CYCLING"
                    },
                    "nfilter": {
                        "effect": "OFF"
                    }
                }
            }
        }
    }
}
```

In this case I was able to modify the powercell effect from `SPINNING` to `CYCLING` in the JSON file, upload it to the device, and the powercell changed as expected. There are helper classes which should greatly reduce code needed in each method.

I will need to add some sanity checks to ensure that invalid/missing values in the JSON files are handled gracefully, at the moment this causes a fatal exception (the device crashes and restarts itself constantly).

I have committed the changes I made so far as the application is in a semi-working state right now and I can build on this fairly easily.

Currently WiFi is not working though, I can't connect from my laptop or my phone. I rolled back to the WiFi configuration branch (which I'm 95% sure was working at the time I pushed the changes), and this isn't working either.
I will reboot my laptop and see if this fixes it. If not, I'll need to invest more time going back and troubleshooting what might have caused it to suddenly stop working.

ajquick, 2023-06-13:
I just downloaded PlatformIO on VS Code. Is there a particular branch you want me to follow along with?

I tried one of the more recently updated branches and didn't get any Wi-Fi to show up or lights.

prodestrian, 2023-06-13:
@ajquick `feature/implement-light-presets` is the very latest version and should work, however I haven't finished porting everything out of the filesystem so you will still need to upload the `/data/config.json` JSON file manually for now.

For debugging I recommend changing `DEBUG 0` to `DEBUG 1` in `Settings.h` before you build the firmware.

You can use the Arduino IDE if that's easier, or via PlatformIO:
```bash
# Upload JSON file from `/data`
pio run --target uploadfs

# Build/Upload firmware
pio run --target upload
```

You can also access the Serial Monitor via:
```bash
pio device monitor --eol=LF
```
(You may not need the `--eol=LF` argument).
This won't output anything unless you've compiled in debug mode (`DEBUG 1`).

Let me know if you have any issues.

ajquick, 2023-06-16:
Here is what I'm seeing so far.

(I don't have a way to control the switches, so my lights are not being tested right now).

I have turned on the webserver and see the Wi-Fi, but I am unable to connect on either my phone or computer. It just immediately kicks me out and says unable to connect.

One thing that I will need to do is test the on-off-on-off-idle function with the actual sound board. There is a possibility it does the start up and then waits for start up to finish before going into shut down. I don't think it is an immediate on-off-on-off like you would do with the switches.

prodestrian, 2023-06-16:
That's useful information, thanks! I think I'll need to revisit the WiFi, it works semi-reliably from my Ubuntu laptop but doesn't work at all from my Android phone. So I'll put together a simple test sketch and get that working smoothly on the hardware, then add the lights back in one piece at a time (making sure it works at each step). It might mean swapping out a dependency or two.

As far as the WiFi activation sequence it's pretty easy to adjust the code for that, so currently it's:
`Startup => Powerdown => Startup => Powerdown => Off`
This can be changed to:
`Startup => Idle => Powerdown => Startup => Idle => Powerdown => Off`
if that's the sequence we get from the soundboard.
It means changing this line here:
https://github.com/gbfans/afterlife-lightkit/commit/a82e7e23a7985bdfec652c1b770b5f01c52fd466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
```c++
if (controls.isSequenceMatch("1:14:1:14:1:14:0")) {
```
We can also add an "or" to this, in case someone tries to trigger WiFi while their pack is already idle (so the sequence might be slightly different), or if somehow the soundboard is sending different combinations of signals.
And if needed we can increase the number of items available in the signal history from `7` to `10`.

ajquick, 2023-06-16:
I will definitely check the sound board and verify what we get exactly.

Is there any time frame it checks for the sequence or is it always just a sequence irrespective of time?

This is almost never going to happen during normal operation:

>Startup => Powerdown => Startup => Powerdown => Startup => Powerdown => Off

But this might if someone turns on the pack without firing twice:

>Startup => Idle => Powerdown => Startup => Idle => Powerdown => Off

prodestrian, 2023-06-17:
At the moment there's no time limit, but because I'm not waiting for an "Idle" state between each cycle it means you have to trigger Powerdown while it's still in Startup. As you say, if the soundboard forces you to wait for Startup to finish (and then sends a quick Idle signal before going into Powerdown) it means what I have above won't work.

I've been at events where I've cycled my pack on/off multiple times without firing, but it's always with minutes/hours of Idle between those powercycles. That's why I was hoping that Powerdown during Startup would be a good way to do this, it seems like you'd have to do it intentionally. But we'll see what the soundboard does, even a single frame of "Idle" signal would stop this from working.

We'll need a timer to automatically deactivate WiFi so I'm more than happy to add another timer for the signals (ie "last signal received").

This would clear the history if more than (let's say 30 seconds) has elapsed since the last signal. Could probably even make it 10 seconds, honestly we're not using the history feature for anything else anytime soon anyway, unless we add a different sequence for quickly changing Presets (ie toggling the pack between Classic & Afterlife modes).

ajquick, 2023-06-18:
One thing to consider is also standalone mode.

https://github.com/gbfans/afterlife-lightkit/issues/15#issuecomment-1181434990

>Upon boot, if all pins are pulled low, it is assumed that the board is under the control of the sound board.
>
>If all pins are pulled high (through pull up resistors) it is assumed the board is in standalone mode.

So Wi-Fi mode might be need to be turned on two different ways. I don't think standalone mode is active right now because the lights should turn on without anything connected.

prodestrian, 2023-06-24:
We have the framework for supporting standalone mode but I haven't implemented it yet.
I
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

Thread 12 (2022-07-03):

Events and Animation Classes

prodestrian, 2022-07-03:
The next feature after #11 is to implement code to handle the Events and Animations.

I propose that we have a set of predefined animations with generic names.
We then have separate classes for the PowerCell and Cyclotron (treating them almost like standalone devices).
We can assign a Mode to each device (Classic, Afterlife, etc).
There would be a list of States, eg "Startup, Shutdown, Idle, Firing, Overheating, Venting".
We will (eventually) use Configuration to map an Animation to a State with a Mode on a Device, ie "Play the Cycling animation backwards at 300ms delay in Red on the Cyclotron when in the Classic Mode while in the Idle state".
The parameters (delay, direction, color) belong outside the animation.

Animations can be generic across both the PowerCell and Cyclotron as we may want the same effect on both devices (with different parameters).
The Classic cylotron animation could be "CYCLING", the Afterlife animation could be "SPINNING".
We need to come up with clear names for the other remaining animations.

Additionally some animations (eg Afterlife SPINNING) will require further parameters, such as width/radius.

We will also need the ability to change speeds on the fly for each animation, including speed up/down. Ideally this could be a method inside the animation class, where we can define a start speed, end speed, and duration (ie "start at 300ms, then speed up to 100ms over 10 seconds").

Brightness control is also important, both as a high-level setting and for individual pixels. For example the Classic startup animation may need to fade up all LEDS, then fade back down again.

We will also need to know when an animation has completed, so that we know when the startup/vent animations have finished and we can move onto the next one.

ajquick, 2022-07-03:
> We will also need the ability to change speeds on the fly for each animation, including speed up/down. Ideally this could be a method inside the animation class, where we can define a start speed, end speed, and duration (ie "start at 300ms, then speed up to 100ms over 10 seconds").
>
> Brightness control is also important, both as a high-level setting and for individual pixels. For example the Classic startup animation may need to fade up all LEDS, then fade back down again.

I believe we should 100% go with the approach @cfunseth did with his [Afterlife Code](https://github.com/cfunseth/AfterlifeCyclotron).

He used the [RAMP library](https://github.com/siteswapjuggler/RAMP) which functions amazingly. I have been testing and modifying Cole's Afterlife library and have tested the RAMP library extensively now. The way it preforms elastic changes in speed and brightness is amazing.

For example if I flip the switch on, the Cyclotron lights fade in and then the speed ramps up to the idle speed. If I flip the switch off, the Cyclotron starts to slow down and then fade off. But if I decide half way to flip the switch back on, it simply starts to increase in brightness and speed again. It makes the Cyclotron behave very much like a real moving object would. It also has the option for non-linear *ramping* action. So it starts out slow and then accelerates up to the top speed and vice versa. Really, really cool effect.

If you would like I can try to apply the RAMP library to the existing code and see what happens. We would need to add a ```setBrightness``` and ```setSpeed``` function and then update them on each light update. Actually fairly easy I am thinking.

prodestrian, 2022-07-03:
Ah yes I was meaning to look into that, it sounded exactly like what we needed. And it looks like we can keep all interactions with RAMP within the FX classes, which keeps that layer completely hidden from the main sketch. I hadn't realised it also supported easing functions, that opens up a whole lot of additional possibilities.

Absolutely on the same page about the Afterlife cyclotron operating more like a motor spinning up/down, it adds so much more realism!

I've got a few more hours of weekend left so I'll start writing some code now and see how far I get.

prodestrian, 2022-07-03:
PR with proof of concept of this working is here: #14

Thread 15 (2022-07-12):

Interfacing with the GBFans Sound Board

ajquick, 2022-07-12:
I was not anticipating this, but it appears the signals sent from the GBFans sound board are not as straight forward as I had anticipated. I was originally operating under this assumption:

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

These are the inputs on the Powercell light kit for standalone operation.

However when a GBFans sound board is used, there is a much different signaling scheme used!

Start up: Pin 10 is high, all others low.
Idle: Pin 7 is high, all others low.
Firing: Pin 7, 8 and 10 are high, Pin 9 is low.
Venting: Pin 7, 9 and 10 are high, Pin 8 is low.
Shutdown: Pin 7, 8 and 9 are high. Pin 10 is low.
Change state: Pin 7 and 10 are high, Pin 8 and 9 is low. (I am assuming this one).
Off: Pins 7-10 are low.

This is actually quite useful as it helps with the timings. Venting is actually signaled when we previously thought it wasn't. Overheating however is not.

I believe it would be good to allow for both GBFans Sound board connections and the standalone mode to be supported. This can be done by seeing how long the enable pin is held high for. If it is held for more than ~3 seconds we know we're in standalone mode.

I believe a class handling the inputs can get created now.

ajquick, 2022-07-12:
Spongeface, the creator of the GBFans Sound Board was generous to explain exactly how the signal schema works from the sound board to the light kit. As it turns out, it is much more in-depth than I had expected.

Each of the 4 wires is a 4 bit (0-15) signal that expresses each state the sound board is in and forwards that data to the light kit.

Pin 7 = MSB
Pin 10 = LSB

| Dec | Pin 7 | Pin 8 | Pin 9 | Pin 10 | Description
|--|--|--|--|--|--|
| 0 | 0 | 0 | 0 | 0 | Off
| 1 | 0 | 0 | 0 | 1 | Power Up
| 2 | 0 | 0 | 1 | 0 | Red Cyclotron Color
| 3 | 0 | 0 | 1 | 1 | Green Cyclotron Color
| 4 | 0 | 1 | 0 | 0 | Blue Cyclotron Color
| 5 | 0 | 1 | 0 | 1 | Orange Cyclotron Color
| 6 | 0 | 1 | 1 | 0 | Automatic Venting Mode
| 7 | 0 | 1 | 1 | 1 | Change Cyclotron Colors*
| 8 | 1 | 0 | 0 | 0 | Normal Operation (Idle)**
| 9 | 1 | 0 | 0 | 1 | Venting Strobe Only
| 10 | 1 | 0 | 1 | 0 | Test Mode
| 11 | 1 | 0 | 1 | 1 | Venting Action with Interaction**
| 12 | 1 | 1 | 0 | 0 | Fire (movie version)
| 13 | 1 | 1 | 0 | 1 | Fire (TVG, overheat version)**
| 14 | 1 | 1 | 1 | 0 | Power Down**
| 15 | 1 | 1 | 1 | 1 | Delay -> Power Up -> Idle*

\* Only available in standalone mode
\**Available in both standalone and controlled mode.

Upon boot, if all pins are pulled low, it is assumed that the board is under the control of the sound board.

If all pins are pulled high (through pull up resistors) it is assumed the board is in standalone mode.

ajquick, 2022-07-17:
Updated with a basic control scheme in this branch: https://github.com/gbfans/afterlife-lightkit/tree/feature/effects-with-ramping-colors-controls

prodestrian, 2022-07-17:
Well, that looks more complex than I was expecting. Your example Control code looks similar to what I'd think we could do.
I don't know if the GBFans soundboard already handles debouncing of the buttons/switches, so maybe we don't need to include the Bounce2 library anymore?

I'm still a little fuzzy on bit operations but I did see some example code for it. This is entirely untested obviously, but maybe it's something like this?
```ino
const int CONTROL_PINS[4] = {7,8,9,10};
byte result;
for ( int count = 0, count <= 3, count++ ) {
    bitWrite(result, count, digitalRead( CONTROL_PINS[count] ));
}
# Do something with result
```
Because if we're interacting with the GBFans board, we don't really need to name the input pins anymore, they're just Pins `7, 8, 9, 10`. So we just need to scan all four of them and work out the current state.

The difficult part is that I don't know how the above states behave. For example, I assume at some point the "Red Cyclotron Color" state will be set, but how is this different to "Normal Operation (Idle)"? Does it quickly flash "Red Cyclotron" then change to "Normal Operation"? If you change to "Green Cyclotron", does it flash that once to change modes then stay on "Normal Operation" too? Or how many milliseconds does it pulse the Cyclotron color change signal?

We probably need to write a little test script which dumps the State to the Serial console so we can record exactly what the Soundboard is doing during all modes. Then we can document this in the code to ensure consistent behaviour.

ajquick, 2022-07-17:
That method of reading the states looks like it may work. I was originally trying to use bytes as well but switched to an INT when I saw that you can't use bytes in Switch / Case. Though I could have made it a large If / Else ladder.

That being said, I think we do want the aspects of the Bounce2 library for two reasons:

1. We mainly want to look for the change in state and Bounce2 makes that easy, yes we can do what Bounce2 does and look for the change in the byte data, but it's already a working library and fairly compact. Is it worth copying code from Bounce2 to only have exactly what we need it to do?

2. We do want to consider the possibility that this kit can work in *standalone* mode as well. Standalone mode would expect that the end user is using switches to command the lights on and off. Now it is entirely possible that we could use byte mode for *controlled* mode and bounce2 for *standalone* mode, but perhaps its better to reuse the variables between each control mode?

>The difficult part is that I don't know how the above states behave. For example, I assume at some point the "Red Cyclotron Color" state will be set, but how is this different to "Normal Operation (Idle)"? Does it quickly flash "Red Cyclotron" then change to "Normal Operation"? If you change to "Green Cyclotron", does it flash that once to change modes then stay on "Normal Operation" too? Or how many milliseconds does it pulse the Cyclotron color change signal?

I think we will need to brainstorm that part a bit more.

There are the following other modes:

* Pack Mode (Red Cyclotron)
* Slime Mode (Green Cyclotron)
* Stasis Mode (Blue Cyclotron)
* Meson Mode (Orange Cyclotron)

Each of these modes will need have their own Idle, Firing, Venting, Shutdown.. etc. configurable animations, see my example here: https://github.com/gbfans/afterlife-lightkit/issues/10. So I believe by sending the Byte command  to trigger Green Cyclotron mode for example, it would be a temporary command sent and the pack would continue in whatever mode it was already in (idle, firing, venting.. etc).

It isn't going to be a priority for the main code, but as long as everything is kept as customizable as possible, it should be no problem to expand later on. The most basic implementation will simply do a ```Color::changeColor(Lights.Cyclotron(),CRGB::Green)```  or whatever the command may be.

ajquick, 2022-07-28:
Added a branch called "[Button-Testing](https://github.com/gbfans/afterlife-lightkit/tree/button-testing)".

This is just a simplified version of the Control.cpp code I am working on in my branch.

I have it connected to the GBFans kit and ran it through a few things, which produced an output like this at the serial port:

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

There are some strange abnormalities occurring. For example it was switching between the different firing modes when I believe it shouldn't have been. It also triggered test mode momentarily. I believe the debounce time of 5ms (or whatever it is set to) may actually be too low. It appears to be catching a few signals as it is changing to another one.

prodestrian, 2022-08-21:
I was playing with my own prototype here and I was getting unreliable readings too.
First thing is I think we need to look at is:
> Upon boot, if all pins are pulled low, it is assumed that the board is under the control of the sound board.
If all pins are pulled high (through pull up resistors) it is assumed the board is in standalone mode.

So, we should probably enable the `INPUT_PULLUP` resistors on those pins.
With nothing connected the board should go into Standalone mode, this would do it.
If I tie all 4 pins to GND I should get Controlled Mode.

Secondly, I think Bounce2 is potentially causing us problems here, it's possible that there's an issue with the millisecond timers that are being used (these are separate instances, after all). You got a random **Test Mode** (`1-0-1-0`) and then it was immediately followed by **Firing with change in speed** (`1-0-1-1`). So it's possible the final bit (Pin 10) hadn't yet debounced, so for up to 5ms you were seeing `10` instead of `11`.

We should ditch Bounce2 and handle the debouncing ourselves. We can use a single timer and just `digitalRead()` all 4 pins at once to determine the current value, and compare it to the last value. If more than the debounce interval has passed, we proceed.

I think I can write up a test sketch for this by building on what you have already.

I also think we should keep this test sketch (and any other useful tests we have) as part of the main repository, so that we can continue using them for troubleshooting in the future. It's definitely easier than having to run multiple working copies of the code, every time I need to troubleshoot my wiring.

ajquick, 2022-08-21:
You are correct the inputs need to be ```INPUT_PULLUP``` on everything but the ```FIRE_BTN_PIN```, which does not have an internal pullup.

On V3 of the board, the pullups are built onto the board, all others need to have ```INPUT_PULLUP```.. and having it activated on V3 will not be an issue, it will just draw a little bit more power.

When ```INPUT_PULLUP``` is enabled, you will be able to successfully see controlled mode or standalone mode at boot.

Bounce 2 may need to go. I will let you look into doing that as it is a little bit beyond my understanding at the moment. That being said, since these are only lights having a few seconds entering ```TEST_MODE``` (which isn't supported anyways) won't be an issue. There would just be a flash of different color lights before continuing on to the next correct mode.

I just pushed a bit of code I've been changing a little bit here:  https://github.com/gbfans/afterlife-lightkit/tree/feature/effects-with-ramping-colors-controls/SOFTWARE/AfterlifeLightKit

I was just starting to implement the JSON config and switching between modes and states.

States = Classic, Slime, Stasis, Meson, Party(?)
Modes = Inactive, Startup, Idle, Firing, Overheating, Venting, Restart, Shutdown

I would like to have the ability to switch from Inactive -> Start Up -> Idle and have it read the configuration and change patterns each step of the way.

prodestrian, 2022-08-21:
@ajquick OK, I've rewritten the button-testing control class completely and I'm getting much more useful data out of it now.
I haven't had time to build a fake GBFans soundboard using an Arduino, and I can't find four pushbuttons in my workshop, so right now I'm literally just moving wires from GND to 5V on my breadboard to control whether the inputs are pressed or not.

Here's my code: https://github.com/gbfans/afterlife-lightkit/commit/042397c8c3e9d94088d1d047e1fb5fc5a14daca7

Uploading this sketch should spit out some useful Serial data.

On boot, it should tell you which mode you're running (Standalone or Controlled). If I leave all 4 pins HIGH, I get Standalone mode. Anything else, I get Controlled mode. So this part seems to work now that we've got rid of Bounce2.
Note that it doesn't do any debouncing on first load, I'm setting the current input State to `99` at boot and then overwriting this when `Controls::init()` is first called. This saves us from having to add any delays to work around debouncing. You can set your debouncing milliseconds to 500ms if you like and it will still give you the correct state at first boot.

I removed the references to different pin functions (ENABLE, FIRE, VENT, CHANGE) because these don't seem to apply anymore? Instead I'm just listing the pins in a constant (corresponding to IDC pins 7,8,9,10; or MSB=>LSB):
`const int INPUT_PINS[4] = {D5,D6,D0,D7};`

I was wasting too much time trying to get `bitWrite` working so for now I'm just adding up the pin values from 0-15 manually.
```ino
  int inputState = 0;
  if (digitalRead( INPUT_PINS[0] ) == HIGH) {
    inputState += 1;
  }
  if (digitalRead( INPUT_PINS[1] ) == HIGH) {
    inputState += 2;
  }
  if (digitalRead( INPUT_PINS[2] ) == HIGH) {
    inputState += 4;
  }
  if (digitalRead( INPUT_PINS[3] ) == HIGH) {
    inputState += 8;
  }
```

But after all that it does work. If I set the third pin HIGH, I get a value of `4` (`STATE_BLUE_CYCLOTRON`). If I also set the second pin HIGH, I get a value of `6` (`STATE_AUTOMATIC_VENTING`). I've tried various combinations and they seem to work, so I believe when you upload my sketch and connect a GBFans board, you _should_ get the correct States written to the Serial monitor.

We won't be doing any of the "business logic" inside the Controls class, so I've added some more methods to help us with this. Here's an example:
```ino
void loop() {
  controls.update();
  if (controls.changed()) {
    Serial.print("CHANGED - Old: ");
    Serial.print(controls.getPreviousState());
    Serial.print(", New: ");
    Serial.println(controls.getCurrentState());
  }
```

So we can tell:
* Have any of the controls changed (ie did we get a new signal from the soundboard?)
* What is the current State?
* What was the previous State?

I'm not sure if there's anything else we need here if the sketch works for you. Feel free to make adjustments if you need to (eg `INPUT_DEBOUNCE_DELAY`), I don't have the hardware so I'm basically just working from Spongeface's info posted above, you might have to make the final changes. If you're still seeing weird behaviour due to TEST_MODE we can add an exclusion for that.

Once it all seems to be working, we'll merge the branch, close this ticket, and move onto the next objective.

ajquick, 2022-12-12:
Can confirm. It works and there are no errant signals detected that I can see. Here is an example of turning on the power, firing, hitting the vent a few times:

```
Boot Mode: Controlled
CHANGED - Old: 1, New: 7
CHANGED - Old: 7, New: 0
CHANGED - Old: 0, New: 8
CHANGED - Old: 8, New: 1
CHANGED - Old: 1, New: 11
CHANGED - Old: 11, New: 1
CHANGED - Old: 1, New: 9
CHANGED - Old: 9, New: 1
CHANGED - Old: 1, New: 9
CHANGED - Old: 9, New: 1
CHANGED - Old: 1, New: 9
CHANGED - Old: 9, New: 1
CHANGED - Old: 1, New: 11
CHANGED - Old: 11, New: 1
CHANGED - Old: 1, New: 7
CHANGED - Old: 7, New: 0
```

>I removed the references to different pin functions (ENABLE, FIRE, VENT, CHANGE) because these don't seem to apply anymore?

As long as the inputs are correctly mapped while in "Standalone" mode, you should be okay. That mode would have you connect your switches directly to the header. (Which basically no one will do.)

prodestrian, 2023-03-13:
I have completed this via #16 and merged it in so I can proceed with the remaining functionality.

Closed 2023-03-13.

Thread 17 (2023-04-08):

[FEATURE] Migration to PlatformIO

prodestrian, 2023-04-08:
This has already mostly been implemented in #14 however it is important enough of a change to require its own Issue.

A new `platformio.ini` file has been created in the repository, containing the settings needed to compile/upload to the ESP8266 D1 Mini Clone on the GBFans Lightkit.

## Instructions
1. Install PlatformIO (either IDE or CLI)
2. Compile the firmware
3. Upload firmware to board
4. Upload Filesystem

**Compiling Firmware**
```bash
cd SOFTWARE/AfterlifeLightKit
pio run
```

**Uploading Firmware to board**
Connect board via USB
```bash
cd SOFTWARE/AfterlifeLightKit
pio run --target upload
```

**Uploading Filesystem to Board**
Connect board via USB
```bash
cd SOFTWARE/AfterlifeLightKit
pio run --target uploadfs
```

prodestrian, 2023-04-08:
## GitHub Actions

I now have a working demo of using GitHub Actions to run CI scripts and compile the firmware binary automatically.

Output from last run:
```
Run pio ci --project-conf=platformio.ini .
********************************************************************************
If you like PlatformIO, please:
- follow us on Twitter to stay up-to-date on the latest project news > https://twitter.com/PlatformIO_Org
- star it on GitHub > https://github.com/platformio/platformio
- try PlatformIO IDE for embedded development > https://platformio.org/platformio-ide
********************************************************************************

Project has been successfully updated!
Processing d1_mini (platform: espressif8266; framework: arduino; board: d1_mini)
--------------------------------------------------------------------------------

(Truncated)

CONFIGURATION: https://docs.platformio.org/page/boards/espressif8266/d1_mini.html
PLATFORM: Espressif 8266 (4.2.0) > WeMos D1 R2 and mini
HARDWARE: ESP8266 160MHz, 80KB RAM, 4MB Flash
PACKAGES:
 - framework-arduinoespressif8266 @ 3.30102.0 (3.1.2)
 - tool-esptool @ 1.413.0 (4.13)
 - tool-esptoolpy @ 1.30000.201119 (3.0.0)
 - toolchain-xtensa @ 2.100300.220621 (10.3.0)
LDF: Library Dependency Finder -> https://bit.ly/configure-pio-ldf
LDF Modes: Finder ~ deep+, Compatibility ~ soft
Library Manager: Installing WiFiManager
Downloading 0% 10% 20% 30%
Unpacking
Library Manager: WiFiManager@0.16.0 has been installed!
Found 41 compatible libraries
Scanning dependencies...
Dependency Graph
|-- Ramp @ 0.6.1
|-- FastLED @ 3.5.0
|-- ArduinoJson @ 6.21.1
|-- WiFiManager @ 0.16.0
|   |-- ESP8266WiFi @ 1.0
|   |-- ESP8266WebServer @ 1.0
|   |-- DNSServer @ 1.1.1
|   |   |-- ESP8266WiFi @ 1.0
|-- LittleFS @ 0.1.0
|-- EEPROM @ 1.0
|-- ESP8266WiFi @ 1.0
|-- ESP8266WebServer @ 1.0
|-- DNSServer @ 1.1.1
|   |-- ESP8266WiFi @ 1.0
Building in release mode

(Truncated)

Retrieving maximum program size .pio/build/d1_mini/firmware.elf
Checking size .pio/build/d1_mini/firmware.elf
Advanced Memory Usage is available via "PlatformIO Home > Project Inspect"
RAM:   [====      ]  42.6% (used 34876 bytes from 81920 bytes)
Flash: [===       ]  32.3% (used 337191 bytes from 1044464 bytes)
Building .pio/build/d1_mini/firmware.bin
Creating BIN file ".pio/build/d1_mini/firmware.bin" using "/home/runner/.platformio/packages/framework-arduinoespressif8266/bootloaders/eboot/eboot.elf" and ".pio/build/d1_mini/firmware.elf"
========================= [SUCCESS] Took 65.92 seconds =========================
```

The next step is to store the `firmware.bin` file as an artifact so that it can be included in a release.

prodestrian, 2023-04-08:
## Firmware Artifacts

We now store the compiled firmware as an artifact at the end of each build, and the list of build environments is defined in the `platformio.ini` file.

Currently we only have `gbfans_d1_mini_v1`, however if newer hardware is ever released we can also include firmware for this (building both at the same time).

Firmware is attached as an Artifact to each Build:
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

For now we can download these firmware files and attach them to releases manually, however we can automate this process later if needed (with each new Git Tag creating a new Draft Release).

prodestrian, 2023-04-30:
## Update
It looks like it's not easy/possible to include the LittleFS Web assets (HTML, JS, CSS) in the compiled firmware file.

This means that users would need to upload both the firmware AND the filesystem, which is much more complex.

So to simplify this, we will need to compile the filesystem data into the firmware directly.

WLED achieves this by compiling their data directory (web assets) into C header files, which are then loaded into memory. We can do something similar, it just means any changes to those web assets will need to be recompiled before being included in the release. See: https://github.com/Aircoookie/WLED/pull/921

We may be able to include this as part of the GitHub Actions pipelines, ideally so that these class files do not need to be tracked in Git. But this may cause additional issues, so it requires investigation.

Thread 19 (2023-06-25):

[FEATURE] Support for TVG Mode

prodestrian, 2023-06-25:
(Moving this from #10 so it doesn't get too confusing)

After reading the soundboard documentation PDF I can see the following:
> The sound board also has a couple of configuration switches on the board to select
between four main modes of operation:
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

OK, so I had no idea what "R2DEVO" was, looks like it's an old pack light kit from 10+ years ago and isn't applicable to this project, so we can ignore it.

## Firing
**Mode 1 (Movie Pack Sounds)** and **Mode 2 (Movie Pack Sounds with Interactive Features)** appear to be exactly the same, except that Mode 2 plays clips from the movie (ie "Nice Shooting, Tex!") after firing finishes.
As far as I can tell there's no difference in the signals that the Soundboard sends to the wand lights in these modes (it will send `STATE_FIRE_MOVIE` either way).

**Mode 3 (TVG Pack Sounds)** is the more complicated one here.
Firing documentation:
> a. Press and hold for continuous firing sounds, like the Proton Stream

Super simple. In Movie mode this will send `STATE_FIRE_MOVIE` until the button is let go. In TVG Mode it will send `STATE_FIRE_TVG` regardless of current TVG setting (ie Proton/Slime/Stasis/Meson).

> b. Press, hold and release for single shot sounds, like the Boson Darts in either TVG sounds configuration

Looks like this also will just send `STATE_FIRE_TVG` for quick bursts, so we already support this, and the pack lights don't currently have to behave differently for these. It could be something we add on later (if firing was only for a fraction of a second we display different animations), but that's out of scope.

> c. Quickly tap to switch between different TVG packs in TVG Pack Sounds configuration

Each time the TVG pack is changed, it looks like this just notifies the pack lights to change Cyclotron color via:
```
STATE_RED_CYCLOTRON, // 2: Red Cyclotron Color
STATE_GREEN_CYCLOTRON, // 3: Green Cyclotron Color
STATE_BLUE_CYCLOTRON, // 4: Blue Cyclotron Color
STATE_ORANGE_CYCLOTRON, // 5: Orange Cyclotron Color
```

## Venting
> The TVG Pack sounds mode also keeps track of the pack's "temperature" and will start beeping when overheating and will auto-vent the pack when it gets too hot. You can also manually vent the pack to cool it down sooner.
> Usually plays the full TVG vent sound in all configurations. In the TVG Pack Sounds configuration, this may make a “dry
vent” sound if the pack is already cool. You must fire something for a while to heat the pack up and then the full vent sound will play.

So, venting exists in both Movie and TVG mode.
We have the following vent states documented from the soundboard:
```
STATE_AUTOMATIC_VENTING, // 6: Automatic Venting Mode
STATE_VENT_STROBE, // 9: Venting Strobe Only
STATE_VENTING_ACTION, // 11: Venting Action with Interaction (both modes)
```

I have no idea what `STATE_VENT_STROBE` is supposed to do here, there's nothing documented about this as far as I can see.
So, can we assume that `STATE_VENTING_ACTION` refers to a manual vent action, and `STATE_AUTOMATIC_VENTING` refers to an automatic one (ie triggered by a full overheat)?
As far as the pack lights go I don't think there's any difference, venting is venting.

So we should be able to treat both the same, via something like:
```c++
    else if (
            controls.isState(STATE_VENTING_ACTION) ||
            controls.isState(STATE_AUTOMATIC_VENTING)
    ) {
        // Venting, either manually or automatically
        lights.setState(PACK_VENTING);
    }
```

I've implemented the above into my demo Arduino Nano sketch, with the difference that my second pushbutton is used to toggle TVG modes instead of manually venting. This should be enough for me to proceed.

prodestrian, 2023-06-25:
## Progress Update

This is now partially working. I can change the mode on the wand and the Cyclotron changes color:
https://www.youtube.com/watch?v=txV1NEvnyz0

The configuration looks like this:
```json
    "modes": {
        "proton": {
            "color": {
                "powercell": "0x0000FF",
                "cyclotron": "0xFF0000",
                "nfilter": "0xFFFFFF"
            }
        },
        "slime": {
            "color": {
                "powercell": "0x0000FF",
                "cyclotron": "0x00FF00",
                "nfilter": "0xFFFFFF"
            }
        },
        "stasis": {
            "color": {
                "powercell": "0x0000FF",
                "cyclotron": "0x0000FF",
                "nfilter": "0xFFFFFF"
            }
        },
        "meson": {
            "color": {
                "powercell": "0x0000FF",
                "cyclotron": "0xFFA500",
                "nfilter": "0xFFFFFF"
            }
        }
    }
```
(NOTE: The Powercell is always Blue for all modes, and the N-Filter is always White, but it would be possible for someone to make these different colors if they wanted).

Until now we haven't supported Venting at all, I am only half way through implementing this instead of Overheating (which is why the Powercell currently cuts out during venting).

Next I will be focusing on refactoring the JSON config/preset file so that it loads correctly, then complete venting support.

prodestrian, 2023-06-25:
## Progress Update

This is now fully completed as far as I can tell.

Changes have been pushed to the `feature/implement-tvg-modes` branch.

I have converted all hard-coded animation configuration into JSON and included it in `config.json`:
https://github.com/gbfans/afterlife-lightkit/blob/8477b6ccc43ae261ad7c45176a82cae04a3466ff/SOFTWARE/AfterlifeLightKit/data/config.json

As you can see, all of the animations come from the JSON file, giving full control to the users:
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

Note that this `config.json` file will eventually be removed in favor of hardcoded presets, this one represents the Afterlife preset.

Also note that I have removed "Overheating" for now from the main sketch. As far as I know the soundboard doesn't support overheating, only "venting". So if we want to support this, we will need to allow users to customize the overheat duration, and perform our own "temperature check" calculation based on this so that it (hopefully) syncs up with the soundboard. This is complicated and so I believe it's worth leaving out for now.

This demo video shows how this works currently:
https://www.youtube.com/watch?v=W8sg6sNQni

**Proton Mode**
```json
        "proton": {
                "powercell": "0x0000FF",
                "cyclotron": "0xFF0000",
                "nfilter": "0xFFFFFF"
        },
```
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

**Slime Mode**
```json
        "slime": {
                "powercell": "0x0000FF",
                "cyclotron": "0x00FF00",
                "nfilter": "0xFFFFFF"
        },
```
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

**Stasis Mode**
```json
        "stasis": {
                "powercell": "0x0000FF",
                "cyclotron": "0x0000FF",
                "nfilter": "0xFFFFFF"
        },
```
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

**Meson Mode**
```json
        "meson": {
                "powercell": "0x0000FF",
                "cyclotron": "0xFFA500",
                "nfilter": "0xFFFFFF"
        }
```
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

## Testing
1. Upload the data to the filesystem:
```bash
pio run --target uploadfs
```
2. Upload the firmware:
```bash
pio run --target upload
```

As far as I can tell this should work with the soundboard, based on what I'm seeing in the documentation.

Thread 23 (2023-06-26):

[BUG] WiFi Access Point does not work on most devices

prodestrian, 2023-06-26:
As discussed in #10 , most devices are not able to connect to the Soft Access Point (SoftAP).

* :heavy_check_mark: My Ubuntu Laptop
* :x: My Samsung phone
* :x: My Google Pixel phone
* :x: My MacOS Desktop

These devices see the access point (SSID) but then fail to connect. My mobile devices immediately disconnect with errors (eg "Association Rejection"). My MacOS desktop behaves as if an invalid password was provided.

I have removed all custom code and tried 6 or 7 sample WiFi access point sketches from various vendors.
All behave the same way.

The Webserver demo we had previously was working on my ESP8266 device but as far as I can tell has never worked on the GBFans board (Lolin Wemos D1 Mini Clone?).

I have tried multiple combinations of Arduino IDE settings for the board, including frequencies and compiler options.
I have tried using the Android Studio debugger (via logcat), nothing obvious showed up in the logs.
I have tried various flags, delays, WiFi options, disconnecting before connecting, clearing the flash memory, etc.
I have performed multiple hours of debugging, too many steps to document here.
I have read through 50+ similar-sounding support threads with no success.
I have tried downgrading to older versions of the libraries, again without success.

So this leads me to believe that one of the following must be the case:
* I have faulty hardware
* I have misunderstood what model the board actually is (and have misconfigured platformIO and my Arduino IDE)
* The board we are using doesn't reliably support Access Point (AP) mode
* There is some kind of undocumented workaround which our specific board needs to get this working

prodestrian, 2023-06-26:
## Testing Update

I have the original ESP8266 board I purchased a year ago before my GBFans board arrived.
I uploaded the exact same webserver sketch to it with zero changes.

It showed up in my Android WiFi list. I connected to it and was immediately shown the Captive Portal screen:
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

It 100% works on this original board. So I'm very confident there's nothing wrong with the code I've written here.

ajquick, 2024-07-20:
Testing:

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

### # 1
D1 Mini Clone from Amazon "MakerFocus"
ESP-12

Desktop: Can connect to AP and access webpage.
Samsung Phone: Can connect to AP and access webpage.

Output power no changes. Seems to have enough power either way.

### # 2
D1 Mini Clone from AliExpress
ESP8622

This is probably the one I sent. It is attached to the board with the full chips. Lets assume this has too high of a power draw to work via USB alone.

Desktop: Can't connect. Network Security Key isn't correct.
Samsung Phone: Can't connect.

Changed TX power to 17.

Desktop: Can't connect.
Samsung Phone: Can't connect.

Changed TX power to 13.

Desktop: Can't connect.
Samsung Phone: Can't connect.

Changed TX power to 10.

Desktop: Can't connect.
Samsung Phone: Can't connect.

Changed TX power to 5.

Desktop: Can't connect.
Samsung Phone: Can't connect.

### # 3
D1 Mini Clone (assuming from Amazon)
ESP8622

This one was one I was originally using to test with. The driver for the CH304 was acting funny so I had to downgrade my driver to get it to work again.

Desktop: Can connect to AP and access webpage.
Samsung Phone: Can connect to AP and access webpage.

Changed TX power to 10.

Desktop: Can connect to AP and access webpage.
Samsung Phone: Can connect to AP and access webpage.

Output power no changes. Seems to have enough power either way.

### My Guess

The board when powered by USB and connected to the full setup (including other chips) is likely not enough to power everything including the power hungry wifi. It is possible this would be fixed when powered correctly from a 12V source or by adjusting the TX power down. What will need to end up happening either way is to swap to a different ESP8266 module. I should be able to do some more testing soon.

ajquick, 2024-07-22:
Tested two more of the # 2 boards from AliExpress.

One mounted on a removable header, along with a complete OpenPack Light Controller backpack.

On it's own, it could not connect to Wi-Fi.

Adjusted TX power down to 17. It could connect and toggle.
Adjusted TX power down to 10. It could connect and toggle.

Installed same board on to the OpenPack Light controller backpack.

It connected briefly at TX power of 17, but it wasn't a really stable connection. Had trouble connecting at any other TX level.

Tested another one of these boards that was hard soldered to the OpenPack board. It could not connect at any of the tested TX power levels.

Lets just say these knock off D1 Mini boards are junk. I am awaiting my 4.0 USB-C versions to arrive soon.

prodestrian, 2024-07-23:
I desoldered the included board and tried it standalone, same WiFi issues. So I agree, they're probably junk. I did have an attempt to review the Android debug logs via Logcat to see if any specific errors jumped out at me but there wasn't anything I could understand there to explain why it would always immediately disconnect from ESPAP and reconnect to my home WiFi.

I plugged an alternative D1 mini into the OpenPack board with the WiFi demo sketch and it works fine. So I don't think there's any reason why the OpenPack board itself might cause issues if it has the right ESP board connected to it.

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

I've had a quick look at the differences between the D1 V3 and V4 boards and there's some helpful threads like this:
https://www.reddit.com/r/esp8266/comments/yxsmk1/wemos_d1_mini_v4_first_look_differences/

Most of it sounds good, but a few small things jumped out at me. Firstly several people said most of the V4 boards they received had faulty WiFi, so we need to ensure we find a reputable source, and definitely test WiFi AP on each board (maybe we need a standalone hardware test sketch?). This was a year ago, maybe things have improved. But that's a worry, don't want batches arriving with 2/3 of the boards faulty.

Second thing was related to the USB power not having a diode or fuse any more on the 5V line. If someone had their GBfans kit powered from a Talentcell, and also connected the D1 to USB to upload new code, would this backfeed into their laptop? I know that on my 3D printer I had to use a special **data-only** USB cable to prevent the 5V of my Ender 3's USB port from damaging my Raspberry Pi', hopefully we don't end up in a similar situation. I haven't read all the replies so I don't know if this is something we have to worry about.

If there's any issues with the V4 I'm sure we can find some reasonably priced good quality V3's. The two I have seem to work perfectly despite their low cost.

ajquick, 2024-07-23:
The 4.0 USB-C works from what I can tell. I have not attached one to a OpenPack board yet though.

I'll take a look at the schematic to see about other issues.

ajquick, 2024-07-23:
I agree the lack of a diode on the VBus is a huge liability. This could be fixed on the OpenPack board by installing two P-channel FETs back to back to cut power. Or alternatively, possibly just having the OpenPack board also supplying the 3.3V volts and not connecting to the +VBus power.
