gbfans/afterlife-lightkit/HARDWARE/Schematic.pdf

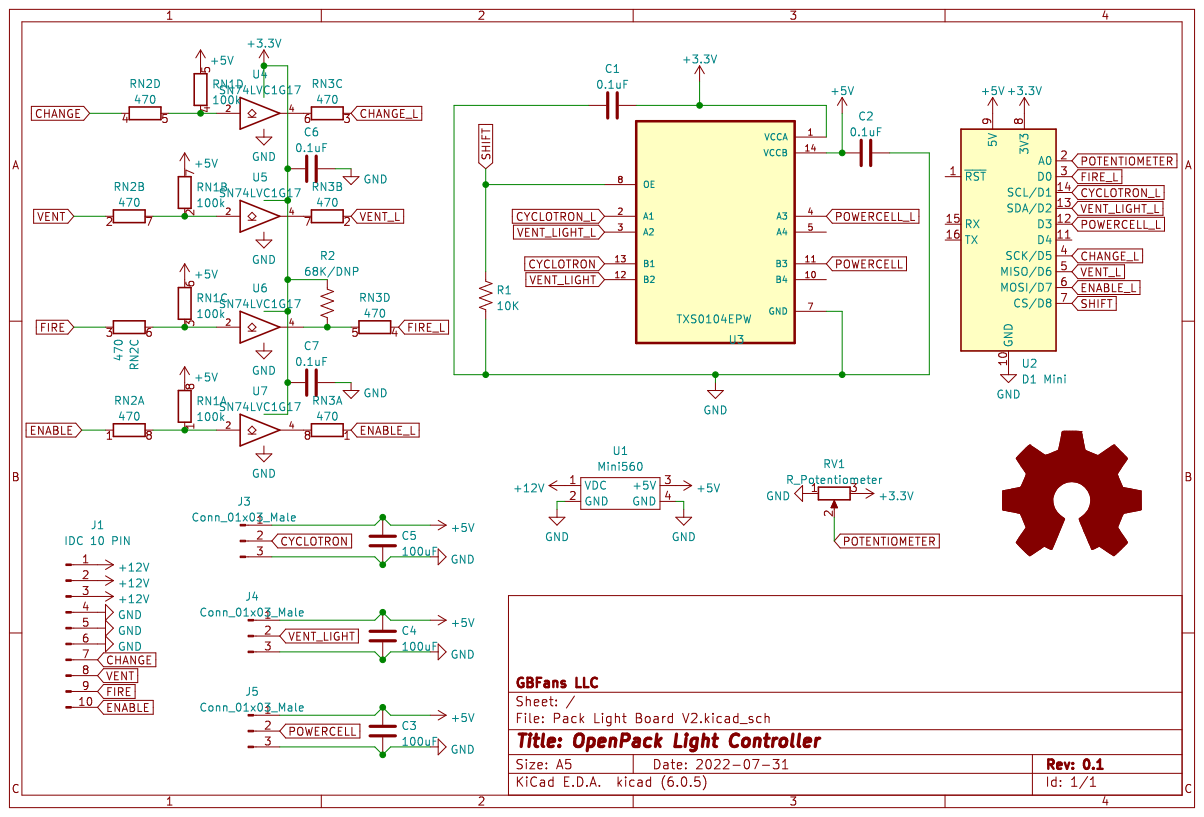
[picture p3: page 1]
