gbfans/afterlife-lightkit/(commit log)

2022-06-20 Update README.md
    Clarify hardware pin configuration
2022-06-20 Add PCB images.
2022-06-21 Added Schematic PDF
    Kicad files to follow after testing.
2022-06-21 README Improvements
    * Add checkboxes to Project Goals to improve readability
    * Reshuffle Project Goals to a more logical order of likely deliverability
    * Reformat Hardware Pin Configuration to Markdown table
    * Add configurable Cyclotron Direction to roadmap
    * Minor typo and styling improvements
    * Add .editorconfig for Arduino code
2022-07-02 Afterlife Sketch Boilerplate Code
    Add initial Arduino sketch with basic library implementation
    * Add ConfigManager to read, deserialize, and process JSON Config
    from LittleFS Filesystem
    * Add Lights class to handle interaction with LEDs via FastLED
    * Add Settings class to define configuration structures
    * Add sample config.json
    * Write initial AfterlifeLightKit.ino sketch
    * Bump editorconfig indent_size from 2 to 4 for readability
2022-07-02 Update ConfigManager.cpp
    Static document size not large enough to handle current configuration. "Failed to read file."
    Change to 1024 for current document size, but be aware of capacity for static JSON documents.
    http://arduinojson.org/v6/assistant
    Added debug to output Json file to Serial.
    [ConfigManager.cpp]
2022-07-03 Update Lights.cpp
    This change forces the power cell to change direction once it reaches the end of the strip.
2022-07-03 Add RAMP library
    This code is untested, but it SHOULD add the ability to elastically change the brightness and speed of the Powercell and Cyclotron animations individually. I also had to change the direction struct to "LIGHT_FORWARD" and "LIGHT_REVERSE" as those were already defined in RAMP.
2022-07-03 Implement Effects (FX) and Ramping
    * Remove all Hardware configuration as this will need to
    be defined in Settings.h from now on
    * Include Ramp.h library: https://github.com/siteswapjuggler/RAMP
    * Rename Directions enum values to avoid conflict with RAMP
    * Create new FX class to handle animations
    * Move animations out of Lights class
    * Add support for Ramping in FX class
    * Add cycling/spinning animations to start with
    * Set Cyclotron to Cycling (Afterlife) and Powercell to Spinning
    * Remove unnecessary/outdated comments
    * Detail requirements for Lights::setState method
    * Add proof of concept of changing Cyclotron speed when firing
    button is pressed, using Ramping
    * Remove unnecessary enu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
    [ConfigManager.cpp, ConfigManager.h, FX.cpp, FX.h, Settings.h]
2022-07-04 Added two new effects.
    RAINBOW lights up all LEDs one color, then the next down the whole rainbow.
    RAINBOW_SCROLL lights up all LEDs in the string a different color of the rainbow and those colors cycle through.
2022-07-05 Add effect Cylon
    This is a Cylon effect that scrolls back and forth. Also added the code to make the powercell go back down.
2022-07-05 Added function "Alternate"
    This function lights up every other LED and then the next tick will light up the next, giving a "marquee" effect. Probably should have called it marquee!
    (Lights up even LEDs and then odd LEDs.)
2022-08-21 Rewrite GBFans Control demo sketch
    * Remove Bounce2 as this was causing unreliable behaviour
    * Remove unnecessary pin definitions in sketch
    * Rewrite Controls class to perform debouncing more consistently
    * Remove unnecessary updateControlled and updateStandalone methods
    * Add simple methods to determine current mode, state, previous state
    * Add changed() method to determine if Controls have changed since last loop
    * Add CONTROL_STATES enum to list all defined GBFans soundboard states
    * Add MODE_ prefixes to both CONTROL_MODES enum values
2022-08-21 Cleanup of Control class
    * Remove unnecessary Serial dumps
    * Remove unnecessary _currentInputState variable
    * Add new STATE_NONE for first boot
    * Remove unused Arduino dependency
2023-03-13 WIP of Controlled FX
    * Move libraries to subfolders
    * Integrate new GBFansControl class to read states from Soundboard
    * Add demo of Startup, Idle, Fire, Overheat, Shutdown states
    * Enhance debouncing of GBFansControl class to reject erroneous signals
    * Implement additional Animations in FX class
    * Add new GBFansControl::duration() method to determine length of current state
    * Add demo code to enable and verify N-Filter LEDs are working
    [ConfigManager.cpp, ConfigManager.h, FX.cpp, FX.h, GBFansControl.cpp, GBFansControl.h]
2023-03-28 Update FX and Light Classes to include newer features
    * Move Lights Update in main loop to reduce potential delays
    * Add power up state
    * Bump default LED brightness from 50 to 255
    * Fix incorrect types in ramp instances which limited delay to 136
    * Remove Brightness Ramp
    * Set Speed Ramp grain to 1ms
    * Add ability to perform reset when changing current Effect
    * Add setReverse method
    * Add TETRIS and DESCEND animations
    * Add private methods to getLedColor, getFirstPixel, getLastPixel
    * Remove unused test methods
    * Improve existing animations
    [FX.cpp, FX.h, Settings.h]
2023-03-28 Fix LED animation glitches
    * Fix bug with multiple millis() calls causing LED glitches
    * Change overheating Cyclotron animation
    [GBFansControl.cpp, GBFansControl.h]
2023-04-08 PlatformIO Migration
    * Refactor application to use PlatformIO
    * Migrate INO sketch to MAIN.CPP file
    * Move includes from CPP to Header files
    * Configure PlatformIO to work with GBFans ESP8266 board (D1 Mini Clone)
    * Fix broken ALTERNATE and TETRIS animations
    * Fix Startup sequence
    * Improve Shutdown sequence
    * Improve Overheating sequence
    * Remove ConfigManager injection from Lights class
    [ConfigManager.cpp, ConfigManager.h, FX.cpp, FX.h, GBFansControl.cpp, GBFansControl.h]
2023-06-12 Implement WiFi Configuration
    * Remove WiFiManager in favour of ESPAsyncWebServer
    * Lock FastLED to 3.6.0
    * Replace all Serial.print* calls with new debug* function
    * Add ability to store history of commands from GBFans Control
    * Add ability to match sequence of received commands
    * Add DEBUG=0/1 compiler option
    * FastLED performance fixes
    * Minor code quality improvements
    * Begin implementation of WiFi Configuration and webserver
    * Add NPM script (borrowed from WLED) to compile HTML UI into PROGMEM
    * Add ability to toggle WiFi by sequence of commands
    [ConfigManager.cpp, FX.cpp, GBFansControl.cpp, GBFansControl.h, Settings.h]
2023-06-12 WIP of Light Presets feature
    * Refactor config.json to new format
    * Update LED color syntax from RGB to Hex codes
    * Add new helper methods to extract LED Strip settings from JSON
    * Add support for dynamic effect modes
    * Remove unused properties on FX class
    * Add new FX::changeSpeedFrom method to set speed changes all at once
    * Namespace enums to prevent conflicts (eg EFFECT_*, PACK_*)
    * Update Structures to match final schema
    [ConfigManager.cpp, ConfigManager.h, FX.cpp, FX.h, GBFansControl.cpp, Settings.h]
2023-06-25 Implement Video Game Modes
    * Refactor config/json file schema to reduce memory footprint
    * Bump reserved StaticJsonDocument memory to reflect new schema
    * Refactor ConfigManager to more cleanly extract JSON configuration
    * Update schema of all Configuration structures
    * Add actual loading of TVG Mode configs (Slime/Stasis/Meson)
    * Restore ability to run animations in reverse
    * Add optional flag to reset LEDs with each animation
    * Add ability to automatically ramp from previous speed to new speed
    without specifying in preset
    * Update Lights class to remove all hard-coded animation settings
    and read from ConfigManager instead
    * Add support for VENTING state and remove OVERHEATING (for now)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
    [ConfigManager.cpp, ConfigManager.h, FX.cpp, FX.h, Settings.h, main.cpp]
